facebookarchive/Surround360/surround360_render/res/example_data/color_calibration_input.png

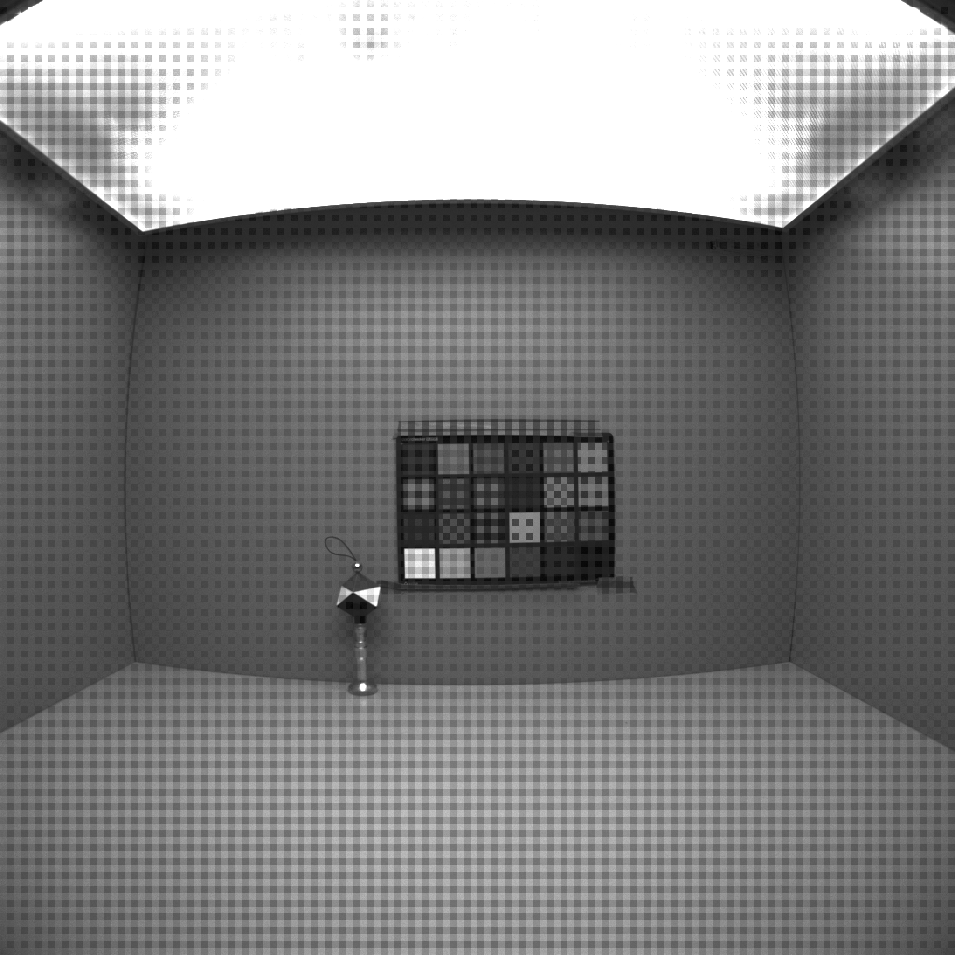
surround360_render/res/example_data/color_calibration_input.png
