facebookarchive/Surround360/surround360_render/res/example_data/test_fisheye_diffuse.png

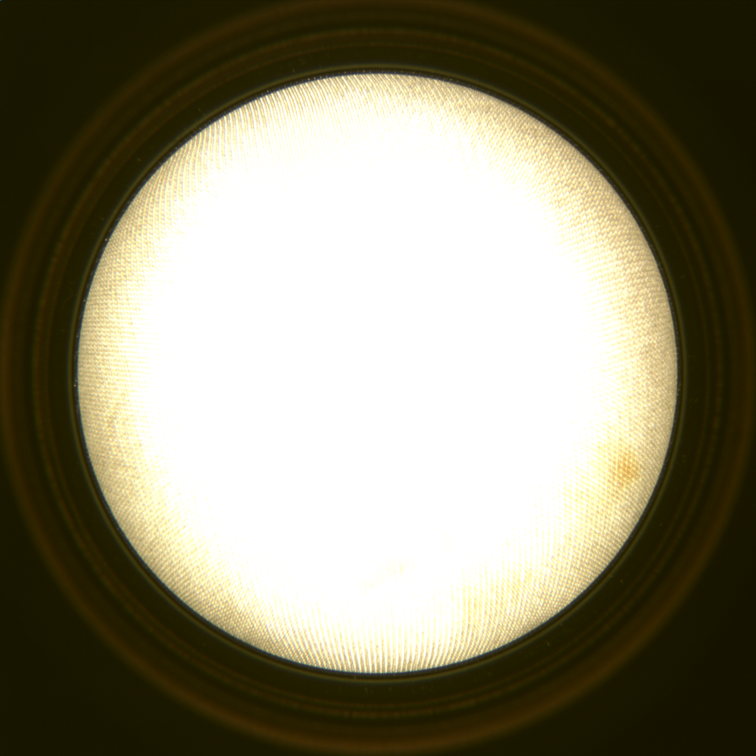
surround360_render/res/example_data/test_fisheye_diffuse.png
