facebookarchive/Surround360/surround360_design/README.md

# Surround 360 Hardware Design

The Surround 360 hardware design consists of blueprints, 3D model files for the base plates and shell, and instructions for assembly.

## Assembly Instructions

Refer to the files under /surround360/surround360_design/assembly_guide

## Join the Surround 360 community

* Website: https://facebook360.fb.com/facebook-surround-360/

See the CONTRIBUTING.md file for how to help out.

## License

The Surround 360 hardware design is licensed under the Creative Commons Attribution 4.0 International license, as it appears in LICENSE_design.md under /surround360_design.
