facebookarchive/Surround360/surround360_render/res/config/isp/README.txt

Field description for configuring the soft ISP

BlackLevel
   3 channel vector value [r, g, b]

     offset in range 0.0, 1.0 where 1.0 == 2^bits_per_channel - This
     varies by camera & sensor vendor. For the usb3 grasshoppers it is
     12.0/255.0 equally for all 3 channels.

Vignette rolloff
   5x3 matrix

       Per-channel 4th order Bezier surface control points, separable on H and V orientations.
       The control points spread uniformly on the image. Each pixel in the image is scaled
       by the corresponding value of the Bezier surface at that location.
       It is not unusual to have each of the channels roll off at different rates to 
       handle chromatic vignetting effects.

WhiteBalanceGain
   3 channel vector value [r, g, b]

       Nominally the red and blue channels are usually around 2x gain
       to the green channels. Strictly speaking this should be
       computed using a global white balance algorithm.

stuckPixelThreshold
   Single value

       The absolute difference of the center pixel from the mean of
       it's neighbors such that it is considered a candidate stuck
       pixel. A value of 0.05 is around 13 pixel counts out of 255.

stuckPixelVarianceThreshold
   Single value

       A measure of local smoothness. Such that if the local region is
       smooth and the center pixel is "candidate stuck" pixel then the
       current pixel is replaced with the local mean.  Both the mean
       and variance calculation excludes the current pixel.

denoise
   Single value

      Noise threshold value.  Zero disables noise coring. Bigger value
      remove more noise but also more signal potentially.

denoiseRadius
    Single value

      Radius for noise reduction 3 or 4 is reasonable.  1 will be fast but will leave low frequency noise behind.

ccm
   3x3 matrix  [[m00, m01, m01], ..., [m20, m21, m22]]

       An identity leaves the color unchanged. This matrix should
       calculated from a color calibration session. It usually best if
       the rows sum to unity to conserve energy.

sharpening
   3 channel vector value [r, g, b]

       1.0 means no sharpening. Below 1.o means blurring and values
       greater than 1.0 will sharpen the image. Excessive
       sharpening will cause "ringing."

saturation
    Single value

      1.0 means no saturation gain.  0.0 means no color at all
      (e.g. B & W) and values greater than one increase saturation.

contrast
     Single value

      1.0 means no contrast gain.  Values greater than one increase
      contrast.

low/high key boost
   3 channel vector value [r, g, b]
   
      Boosts low/high key colors, effectively increasing the color difference on the dark/bright
      areas of the image. It applies a 4-point Bezier curve between 0.0 and 0.5 (low key) or
      0.5 and 1.0 (high key).
      Both low/high key default to 0.0 (= flat, no change), and they can range between 
      -0.1666 and 0.1666 (-1/6 and 1/6).

gamma
   3 channel vector value [r, g, b]

      Raises the pixel value to the power of the gamma value. 0.454545
      is the  classic 2.2 gamma  used to to  move from linear  sRGB to
      gamma corrected sRGB.

bayerPattern
    Single value string

      The string is expected to contain a combination of "R" "G" and
      "B" in the payer pattern order left to right, top to bottom. So
      a Bayer pattern of:

         R G
         G B

      Would be "RGGB"
