facebookarchive/Surround360/surround360_render/res/example_data/intrinsic_checkerboard.png

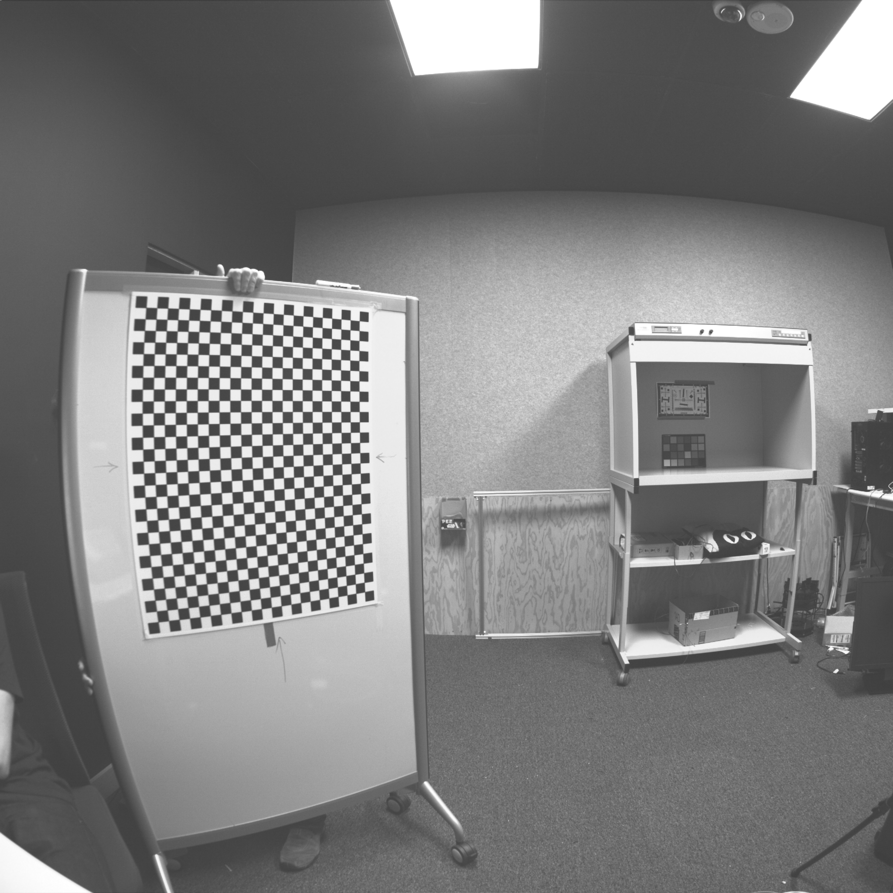
surround360_render/res/example_data/intrinsic_checkerboard.png
