facebookarchive/Surround360/surround360_render/res/pole_masks/cam15.png

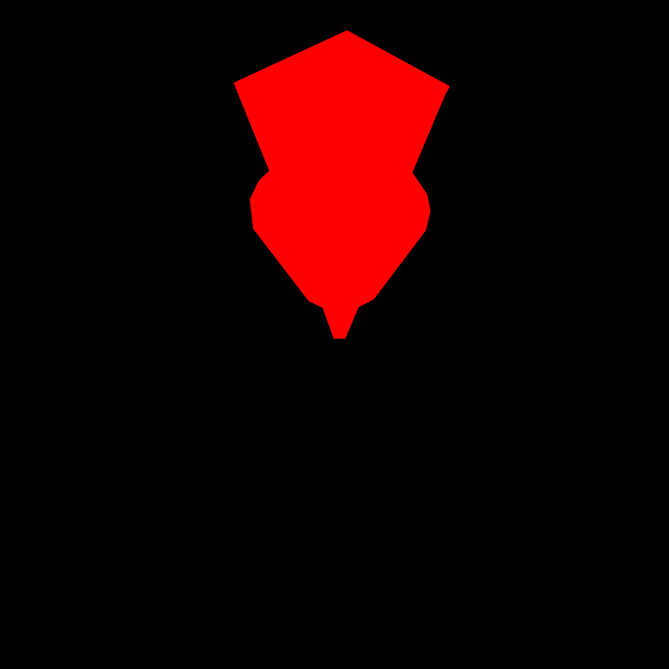
surround360_render/res/pole_masks/cam15.png
