facebookarchive/Surround360/surround360_design/3d_models/STEP_files/160523_3.STEP

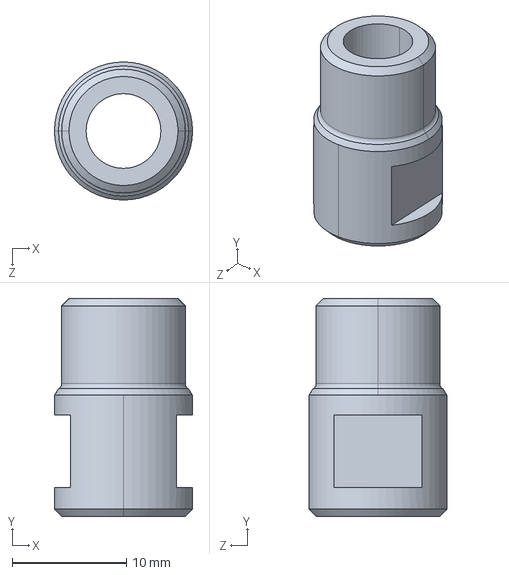
[picture p6: CAD file, 2016-07-26]
surround360_design/3d_models/STEP_files/160523_3.STEP
12.1 x 19.1 x 12.1 mm
