facebookarchive/Surround360/surround360_design/3d_models/STEP_files/FB360_V1_21.STEP

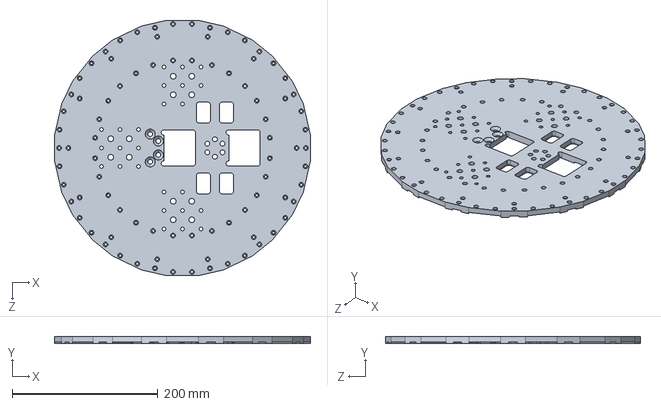
[picture p8: CAD file, 2016-07-26, an earlier design]
surround360_design/3d_models/STEP_files/FB360_V1_21.STEP
351.1 x 9.52 x 350.0 mm
