facebookarchive/Surround360/surround360_design/3d_models/STEP_files/FB360_V1_24.STEP

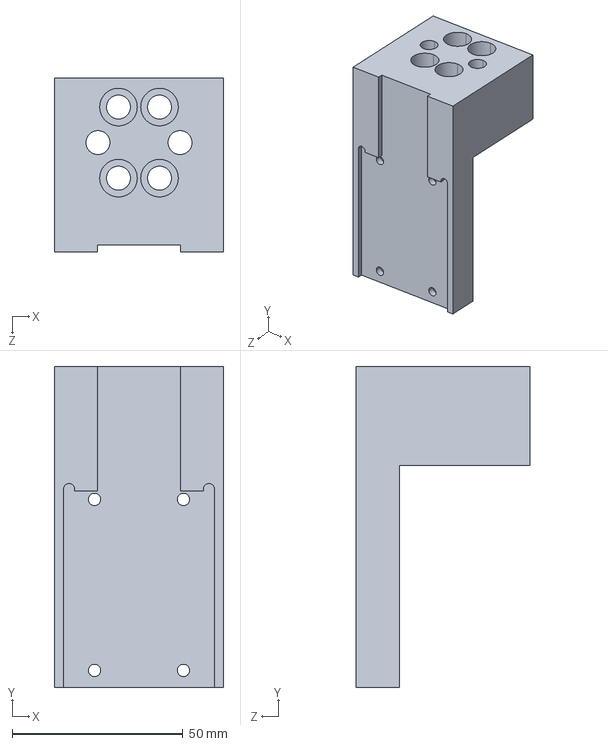
[picture p9: CAD file, 2016-07-26, an earlier design]
surround360_design/3d_models/STEP_files/FB360_V1_24.STEP
49.5 x 93.9 x 50.8 mm
