facebookarchive/Surround360/surround360_design/3d_models/STEP_files/FB360_V1_32.STEP

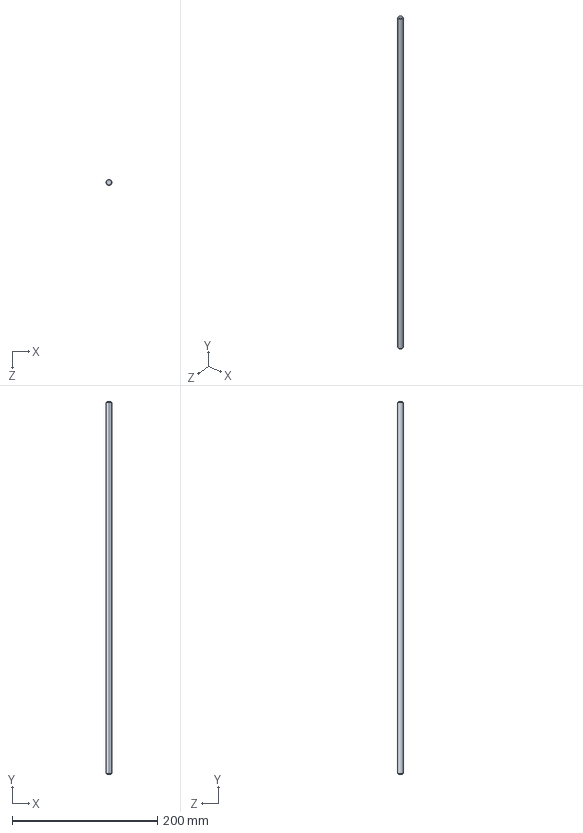
[picture p10: CAD file, 2016-07-26, an earlier design]
surround360_design/3d_models/STEP_files/FB360_V1_32.STEP
7.94 x 514.4 x 7.94 mm
