facebookarchive/Surround360/surround360_design/3d_models/STEP_files/FB360_V1_27.STEP

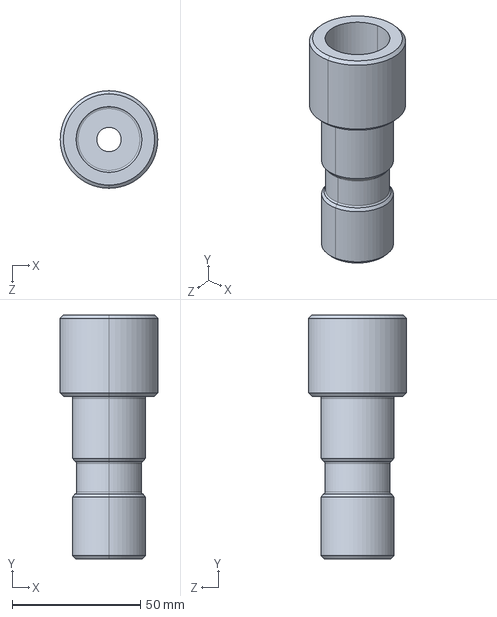
[picture p11: CAD file, 2016-07-26, an earlier design]
surround360_design/3d_models/STEP_files/FB360_V1_27.STEP
38.1 x 95.2 x 38.1 mm
