facebookarchive/Surround360/surround360_design/3d_models/STEP_files/FB360_V1_25.STEP

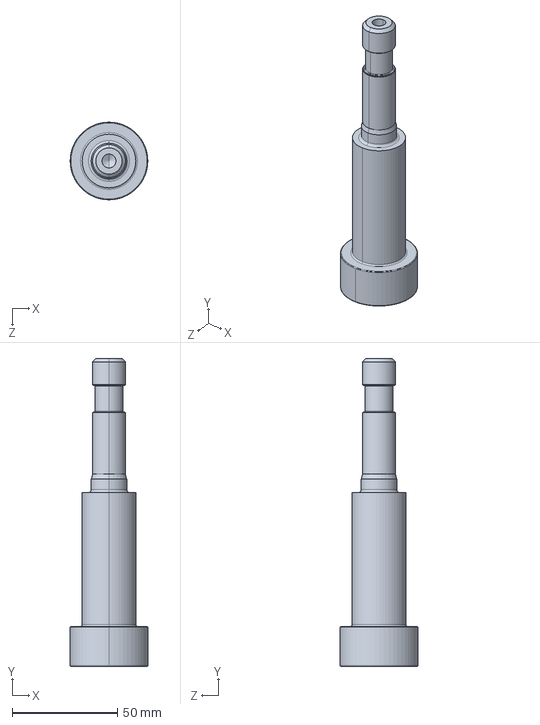
[picture p13: CAD file, 2016-07-26, an earlier design]
surround360_design/3d_models/STEP_files/FB360_V1_25.STEP
36.8 x 146.0 x 36.8 mm
