facebookarchive/Surround360/surround360_design/3d_models/STEP_files/FB360_V1_28.STEP

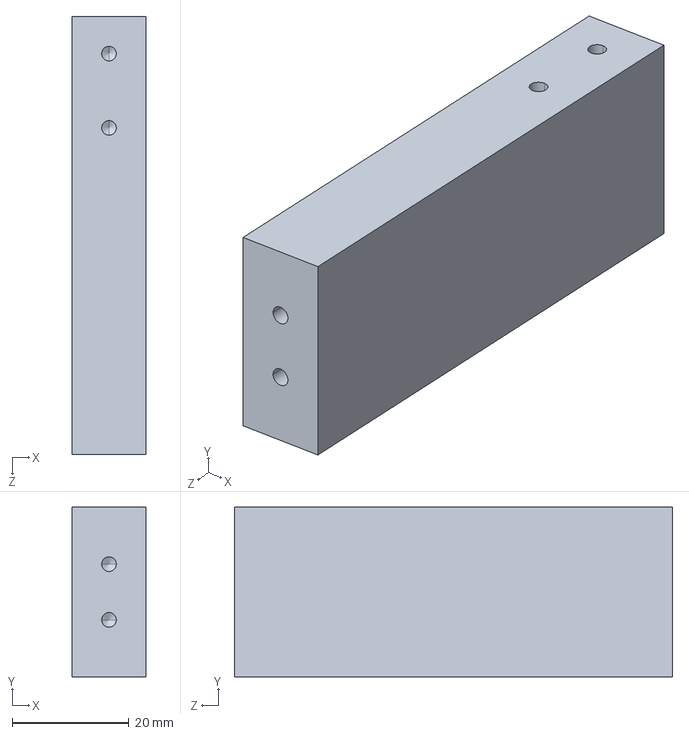
[picture p14: CAD file, 2016-07-26, an earlier design]
surround360_design/3d_models/STEP_files/FB360_V1_28.STEP
12.6 x 29.0 x 74.9 mm
