facebookarchive/Surround360/surround360_design/3d_models/STEP_files/FB360_V1_26.STEP

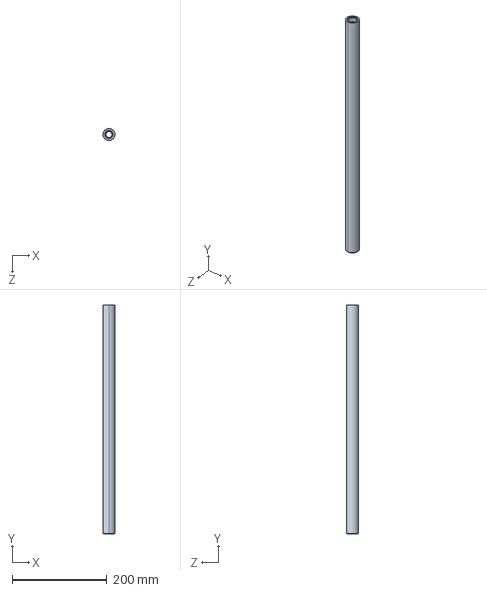
[picture p15: CAD file, 2016-07-26, an earlier design]
surround360_design/3d_models/STEP_files/FB360_V1_26.STEP
25.4 x 482.6 x 25.4 mm
