facebookarchive/Surround360/(list of files, cad)

Other CAD files:
surround360_design/3d_models/STEP_files/FB360_V1_31.STEP
