facebookarchive/Surround360/surround360_render/res/example_data/vignetting_calibration_fit.png

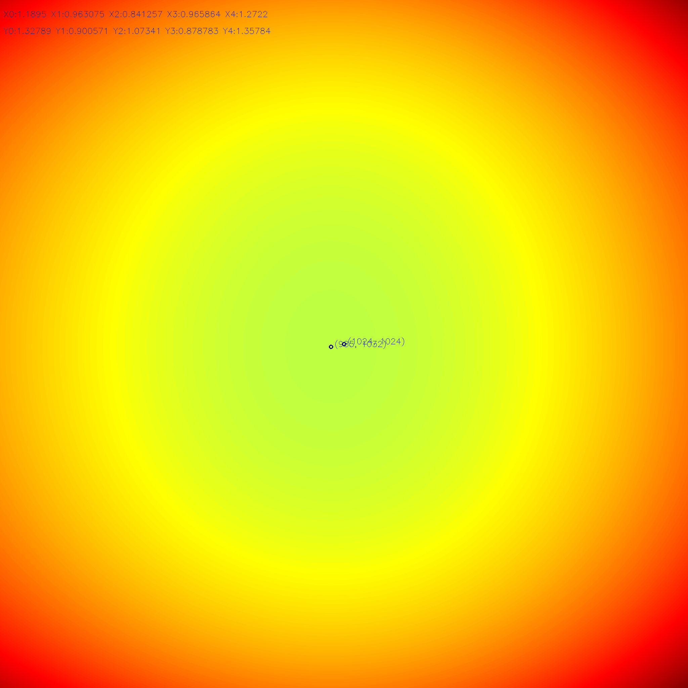
surround360_render/res/example_data/vignetting_calibration_fit.png
