facebookarchive/Surround360/surround360_design/drawings/FB360_V1_ALL.pdf

12

A

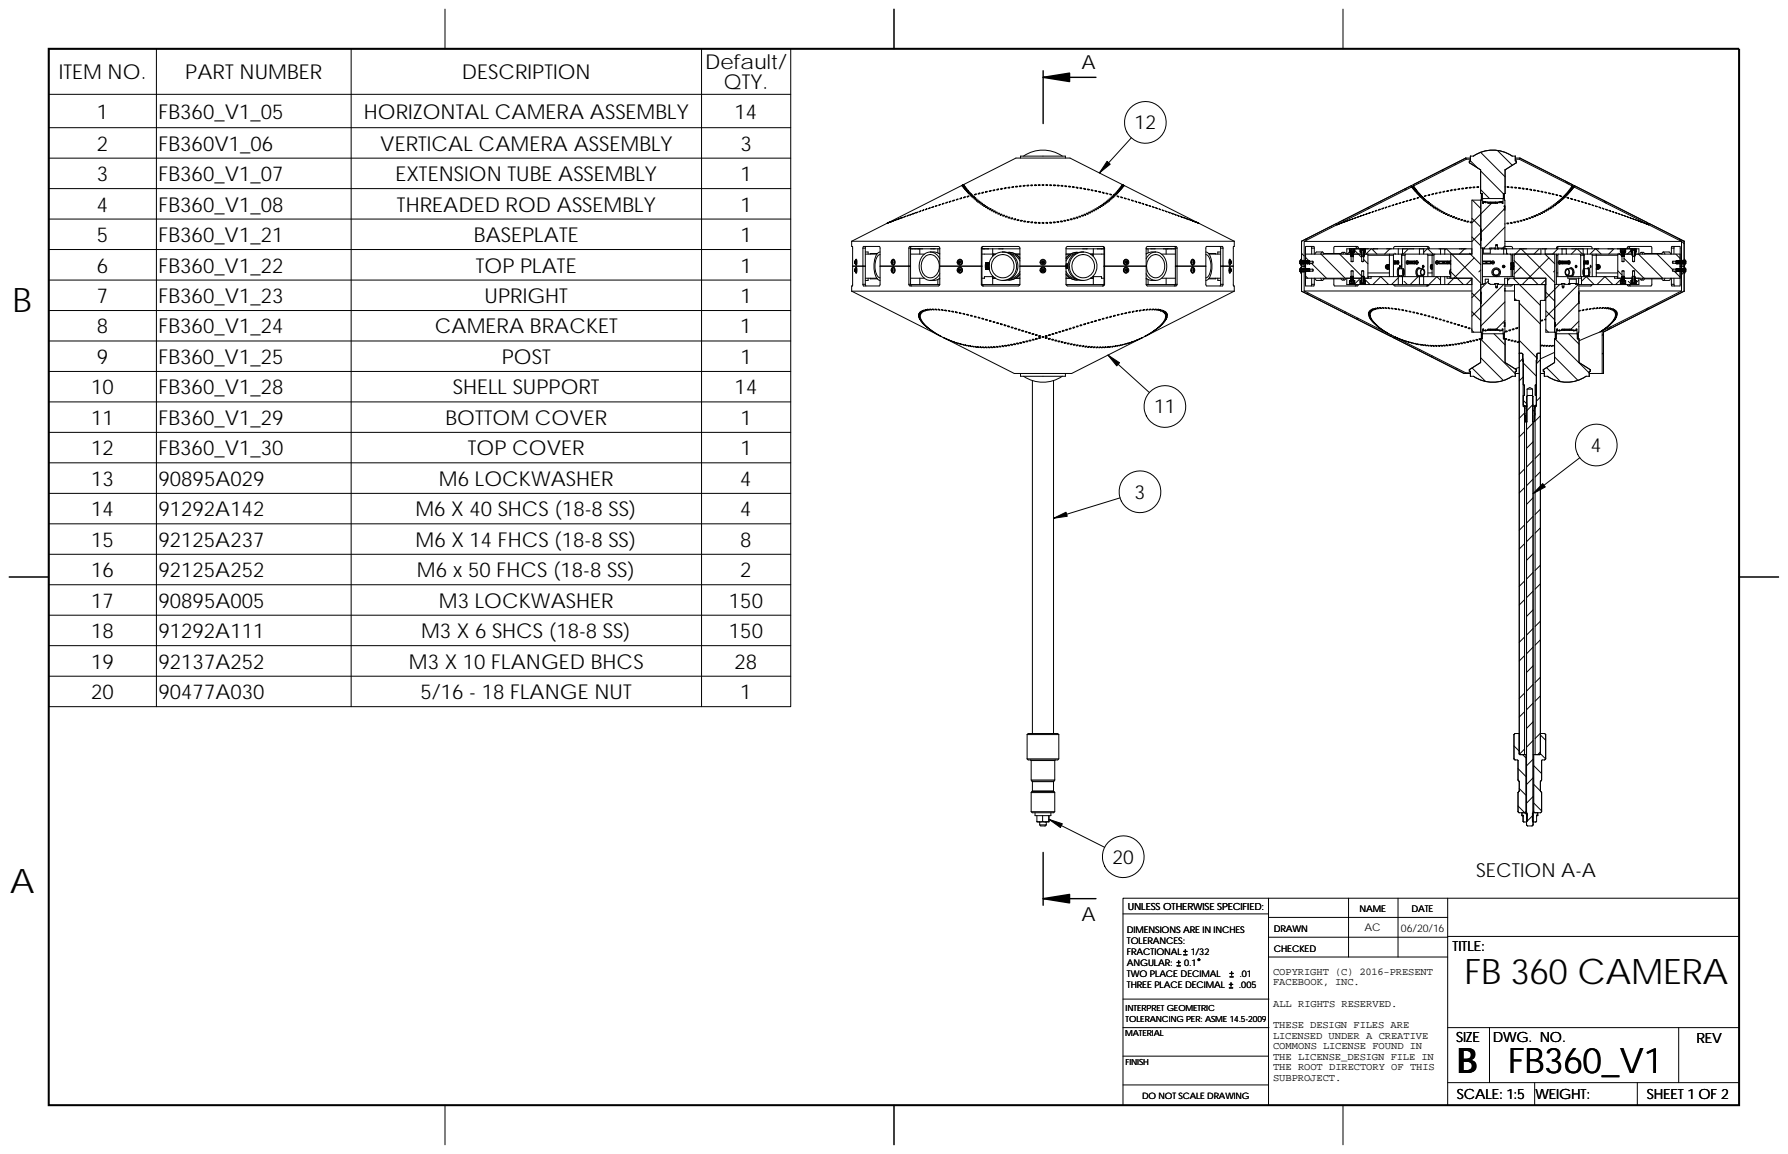
[picture p17: page 1]
SECTION A-A; ITEM NO.; PART NUMBER; DESCRIPTION; Default/ QTY.; HORIZONTAL CAMERA ASSEMBLY; VERTICAL CAMERA ASSEMBLY; EXTENSION TUBE ASSEMBLY; THREADED ROD ASSEMBLY; BASEPLATE; TOP PLATE; UPRIGHT; CAMERA BRACKET; POST; SHELL SUPPORT; BOTTOM COVER; TOP COVER; M6 LOCKWASHER; M6 X 40 SHCS (18-8 SS); M6 X 14 FHCS (18-8 SS); M6 x 50 FHCS (18-8 SS); M3 LOCKWASHER; M3 X 6 SHCS (18-8 SS); M3 X 10 FLANGED BHCS; 5/16 - 18 FLANGE NUT; FB 360 CAMERA; SHEET 1 OF 2; SCALE: 1:5; WEIGHT:; DWG. NO.; REV; SIZE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

UNLESS OTHERWISE SPECIFIED:

DIMENSIONS ARE IN INCHES
TOLERANCES:
FRACTIONAL 1/32
FRACTIONAL
ANGULAR:
ANGULAR: 0.1
TWO PLACE DECIMAL
THREE PLACE DECIMAL

DRAWN DRAWN DRAWN | AC | 06/20/16

CHECKED

COPYRIGHT (C) 2016-PRESENT
FACEBOOK, INC.
ALL RIGHTS RESERVED.
THESE DESIGN FILES ARE
LICENSED UNDER A CREATIVE
COMMONS LICENSE FOUND IN
THE LICENSE_DESIGN FILE IN
THE ROOT DIRECTORY OF THIS
SUBPROJECT.

INTERPRET GEOMETRIC
TOLERANCING PER: ASME 14.5-2009
MATERIAL

DO NOT SCALE DRAWING

# NOTE: ITEM NUMBERS 3, 4, 11, 12 AND 20 REMOVED FOR CLARITY

# NOTE: ITEM NUMBERS 3, 4, 6, 11, 12 AND 20 REMOVED FOR CLARITY

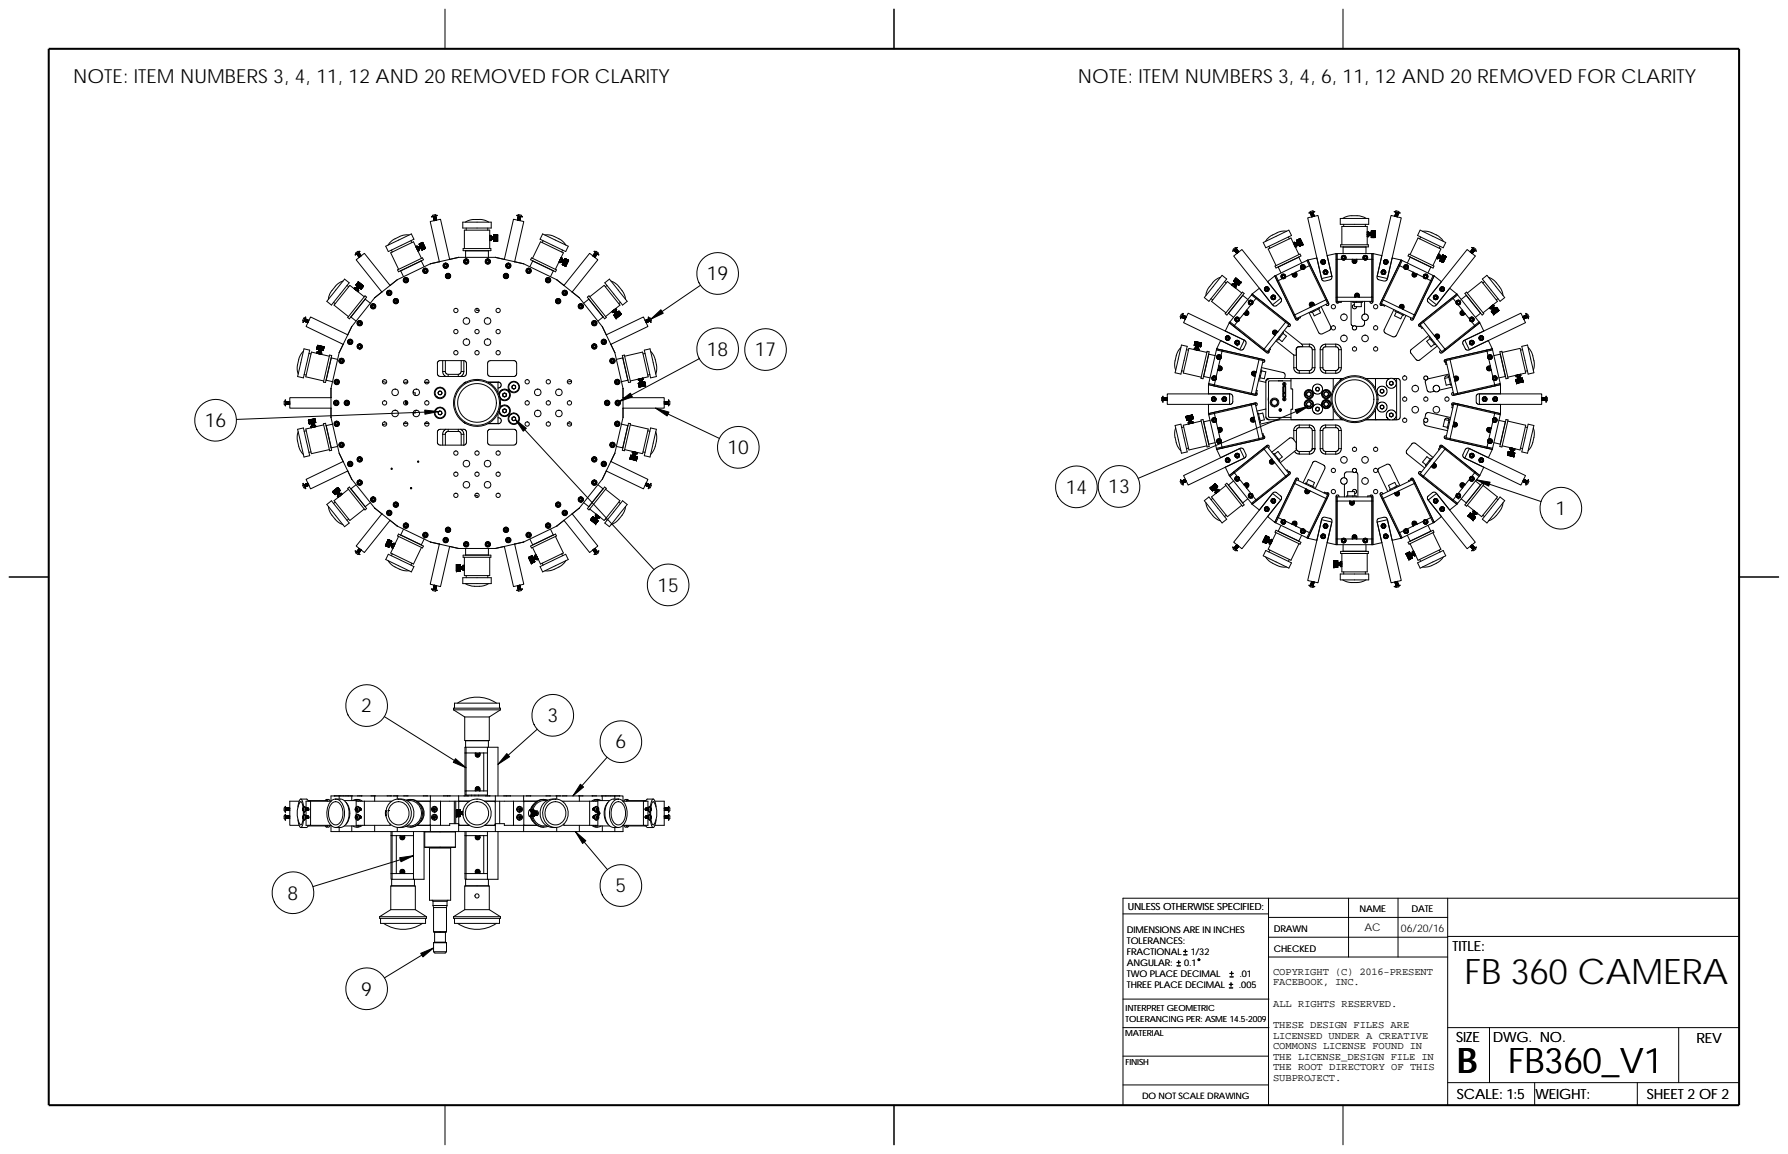
[picture p18: page 2]
SCALE: 1:5; WEIGHT:; DWG. NO.; REV; SIZE; INTERPRET GEOMETRIC; MATERIAL

UNLESS OTHERWISE SPECIFIED: | | NAME | DATE
DIMENSIONS ARE IN INCHES TOLERANCES: TOLERANCES: FRACTIONAL 1/32 1/32 .01 ANGULAR: ANGULAR: 0.1 TWO PLACE DECIMAL TWO PLACE DECIMAL .01 THREE PLACE DECIMAL .005 | DRAWN | AC | 06/20/16
CHECKED | | | TITLE: TITLE: FB 360 CAMERA

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

INTERPRET GEOMETRIC
TOLERANCING PER: ASME 14.5-2009
MATERIAL

ITEM NO. | PART NUMBER | DESCRIPTION | QTY.
1 | PT_GRY_CAMERA | CAMERA MODULE | 1

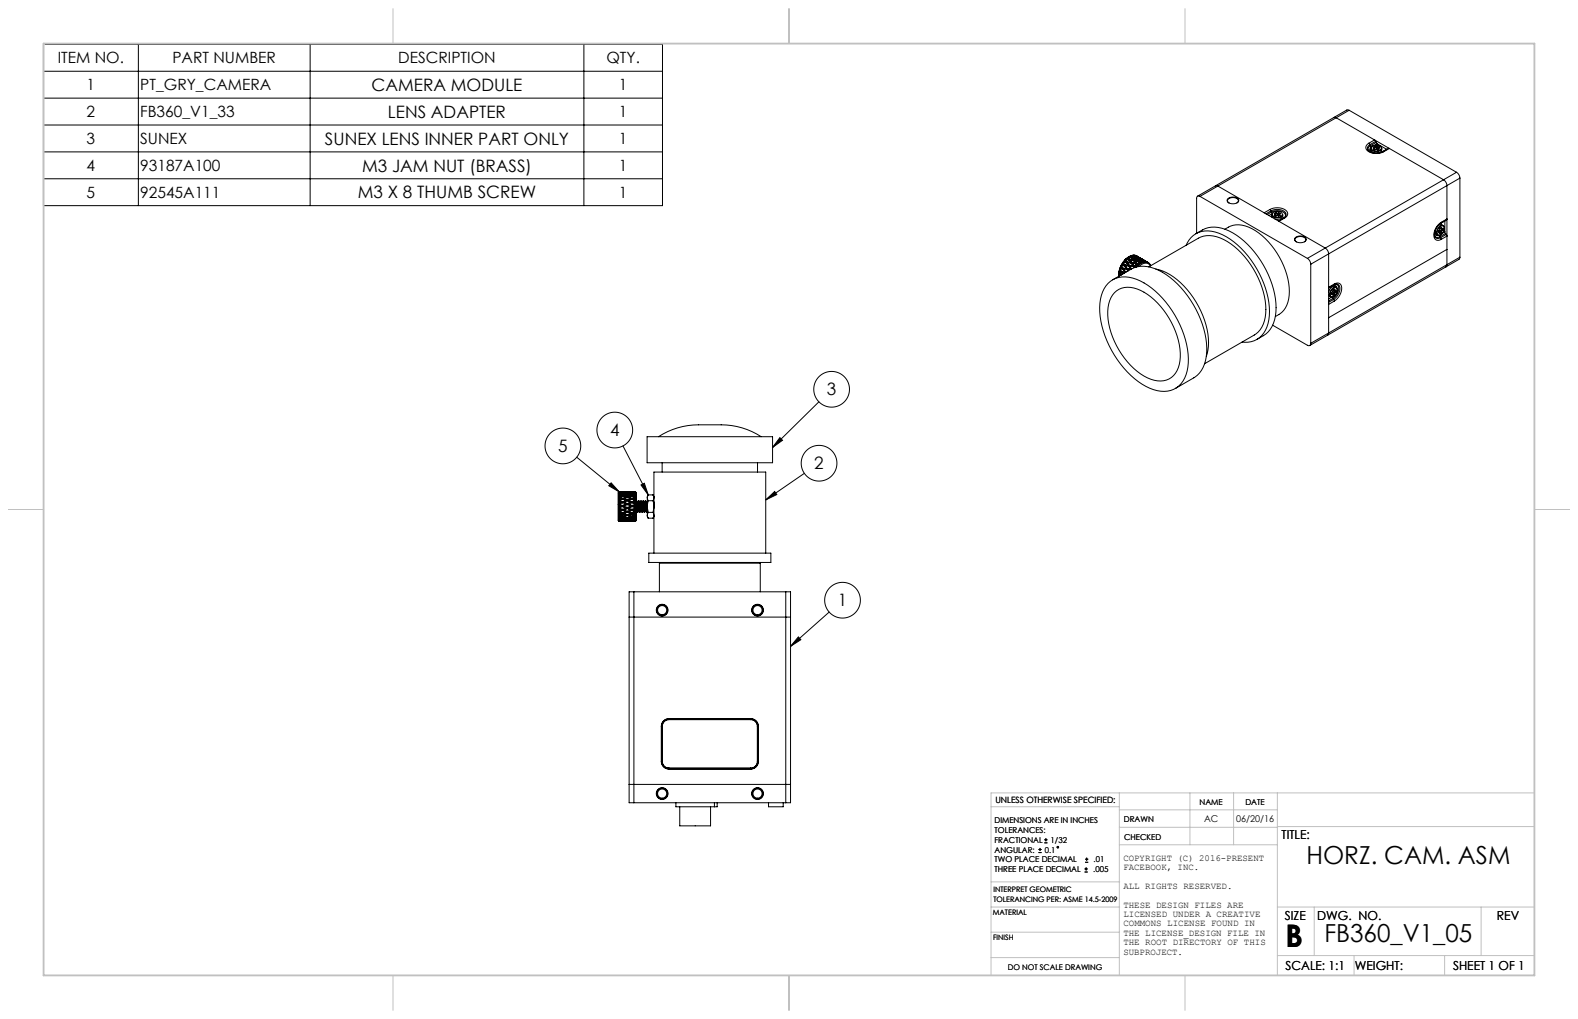
[picture p19: page 3]
SCALE: 1:1; WEIGHT:; DWG. NO.; REV; SIZE; DO NOT SCALE DRAWING; SHEET 1 OF 1

2 | FB360_V1_33 | LENS ADAPTER | 1
3 | SUNEX | SUNEX LENS INNER PART ONLY | 1
4 | 93187A100 | M3 JAM NUT (BRASS) | 1
5 | 92545A111 | M3 X 8 THUMB SCREW | 1

UNLESS OTHERWISE SPECIFIED: | | NAME | DATE
DIMENSIONS ARE IN INCHES DIMENSIONS ARE IN INCHES TOLERANCES: TOLERANCES: FRACTIONAL 1/32 FRACTIONAL 1/32 ANGULAR: 0.1 ANGULAR: 0.1 TWO PLACE DECIMAL TWO PLACE DECIMAL .01 .01 THREE PLACE DECIMAL .005 THREE PLACE DECIMAL .005 | DRAWN | AC | 06/20/16

CHECKED | | | TITLE: TITLE: HORZ. CAM. ASM

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

INTERPRET GEOMETRIC
TOLERANCING PER: ASME 14.5-2009
MATERIAL

ITEM NO. | PART NUMBER | DESCRIPTION | QTY.
1 | PT_GRY_CAMERA | CAMERA MODULE | 1

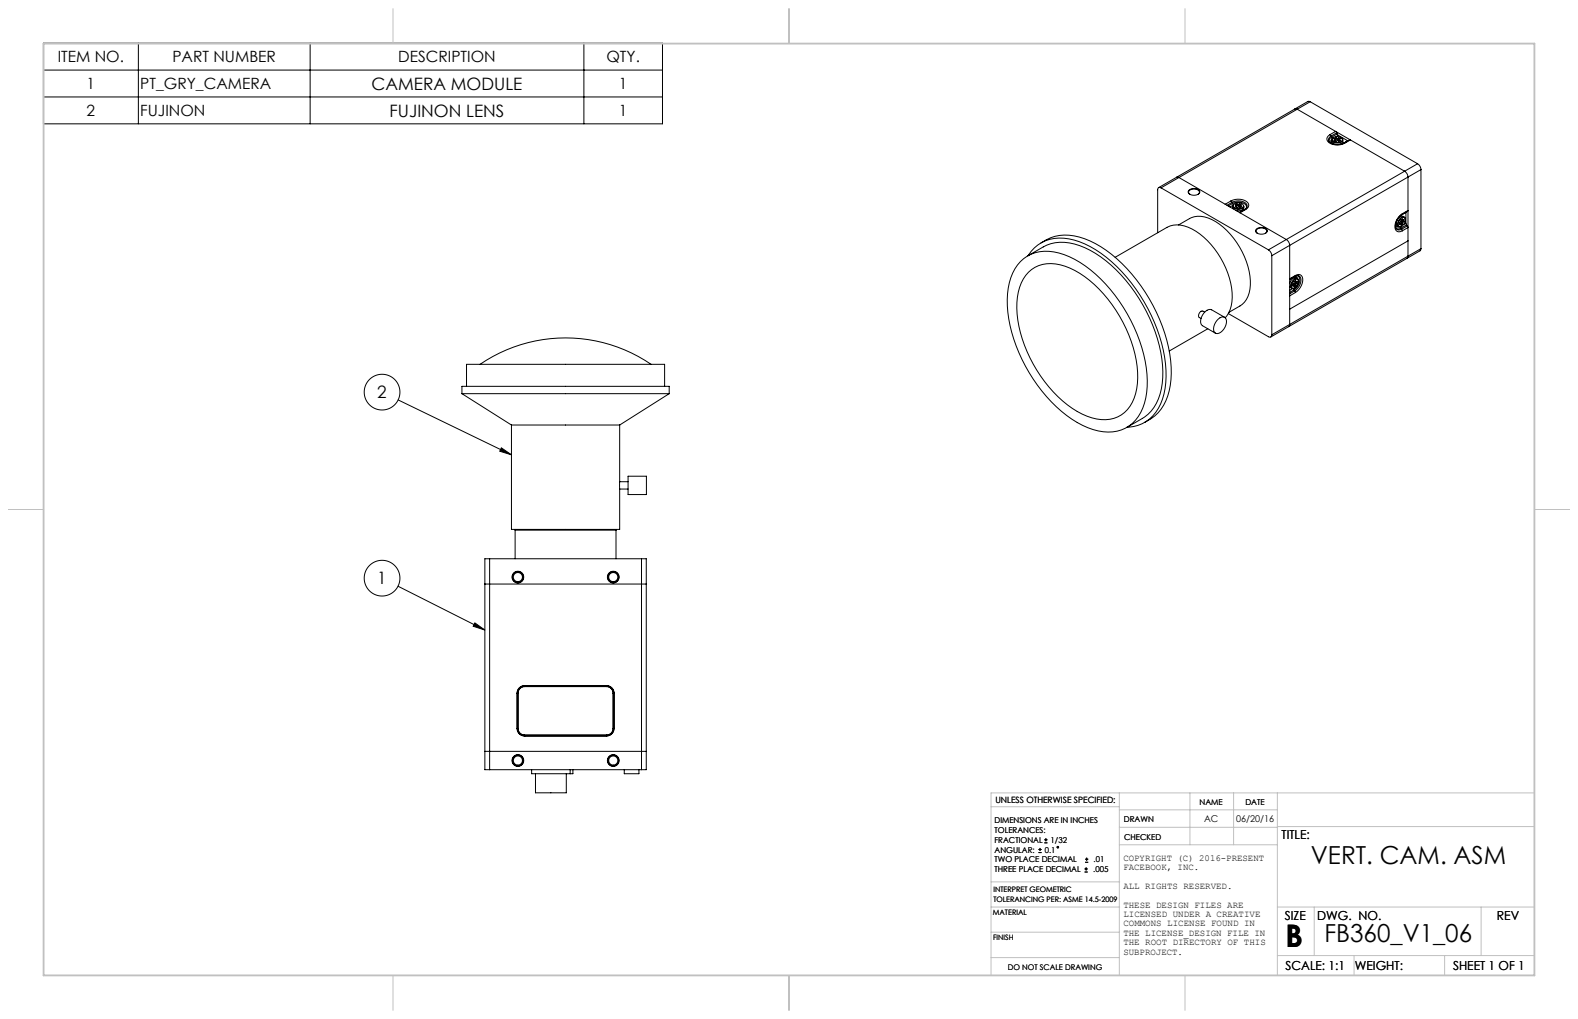
[picture p20: page 4]
SCALE: 1:1; WEIGHT:; DWG. NO.; REV; SIZE

2 | FUJINON | FUJINON LENS | 1

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

CHECKED | | | TITLE: TITLE: VERT. CAM. ASM

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

INTERPRET GEOMETRIC
TOLERANCING PER: ASME 14.5-2009
MATERIAL

A

ITEM NO. | PART NUMBER | DESCRIPTION | QTY.

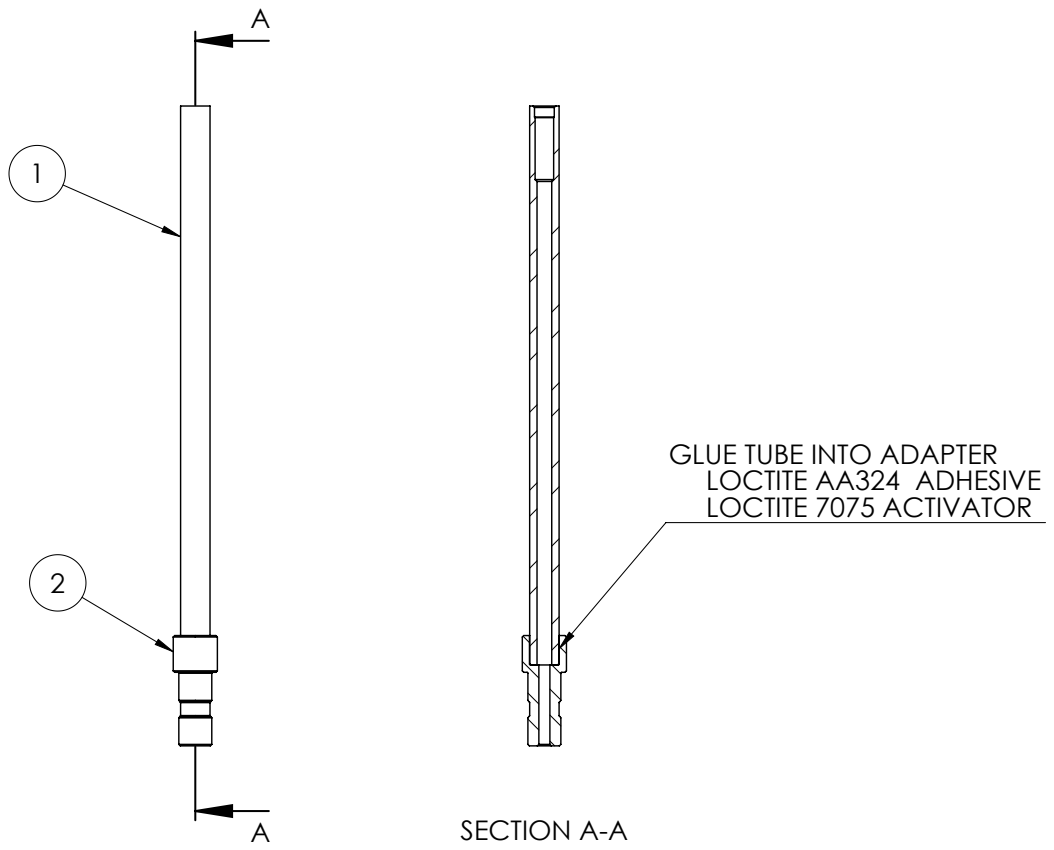
[picture p21: page 5]
SECTION A-A; SCALE: 1:5; WEIGHT:; DWG. NO.; REV; SIZE

1 | FB360_V1_26 | SUPPORT TUBE | 1
2 | FB360_V1_27 | ADAPTER | 1

GLUE TUBE INTO ADAPTER
LOCTITE AA324 ADHESIVE
LOCTITE 7075 ACTIVATOR

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

CHECKED | | | TITLE: TITLE: POST ASM.

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

INTERPRET GEOMETRIC
TOLERANCING PER: ASME 14.5-2009
MATERIAL

ITEM NO. | PART NUMBER | DESCRIPTION | QTY.
1 | FB360_V1_32 | 5/16-18 B7 THREADED ROD | 1

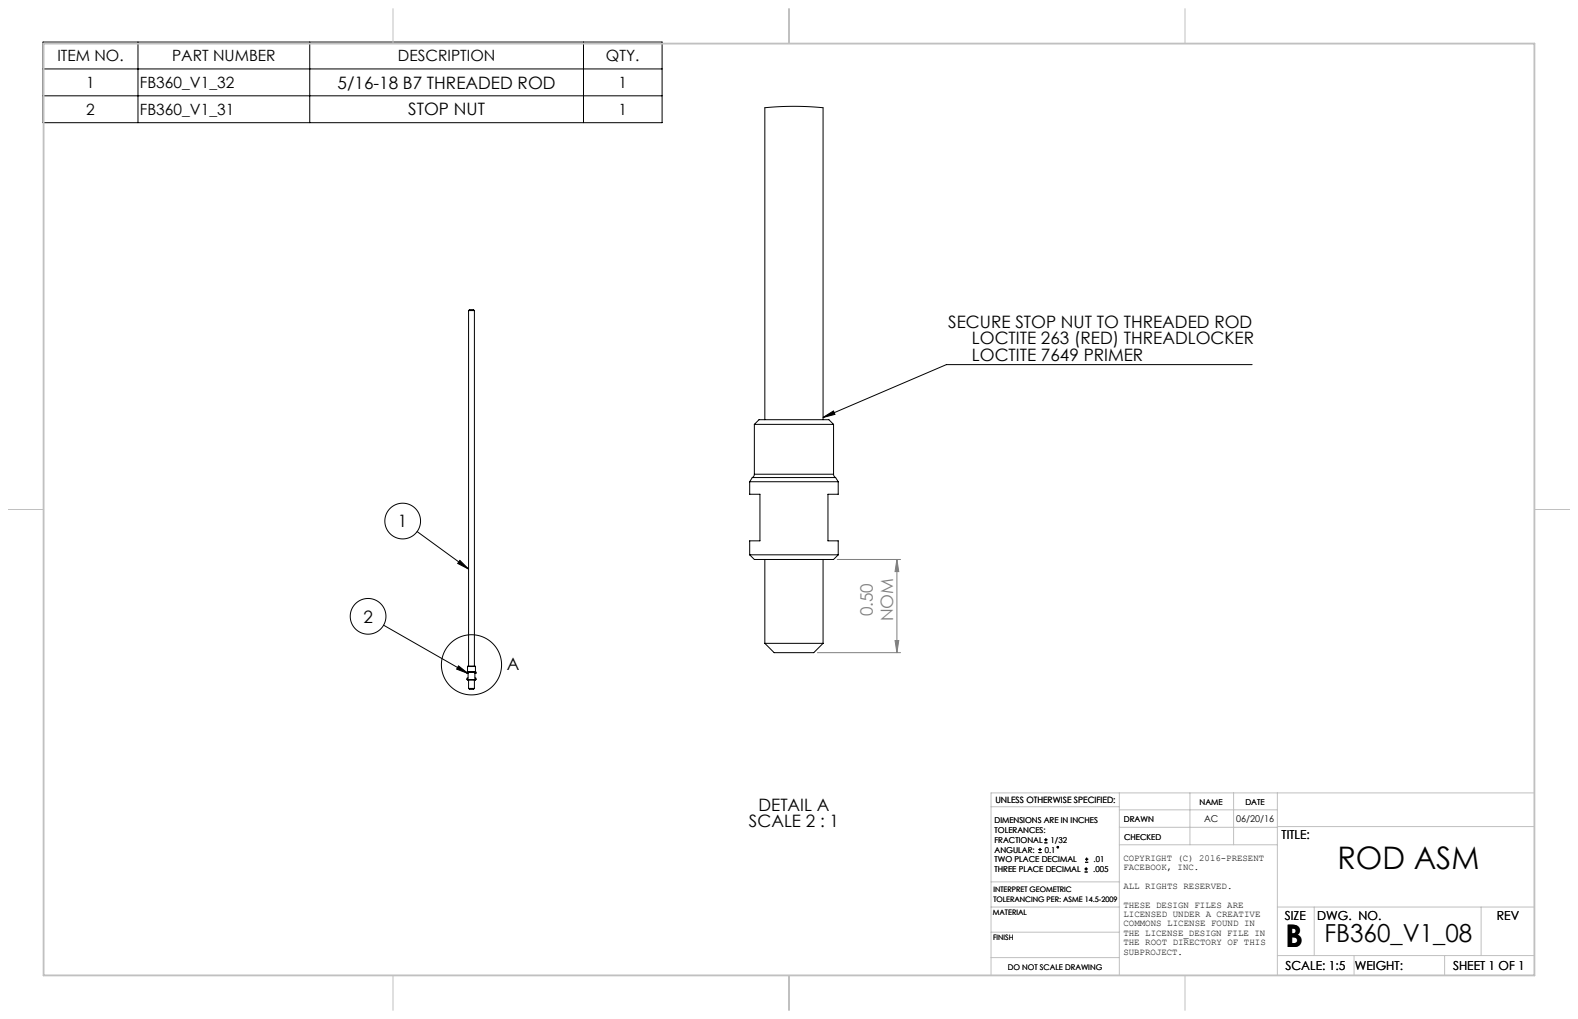
[picture p22: page 6]
NOM; DETAIL A SCALE 2 : 1; SCALE: 1:5; WEIGHT:; DWG. NO.; REV; SIZE

2 | FB360_V1_31 | STOP NUT | 1

SECURE STOP NUT TO THREADED ROD
LOCTITE 263 (RED) THREADLOCKER
LOCTITE 7649 PRIMER

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

CHECKED | | | TITLE: TITLE: ROD ASM

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

INTERPRET GEOMETRIC
TOLERANCING PER: ASME 14.5-2009
MATERIAL

1.741
1.739

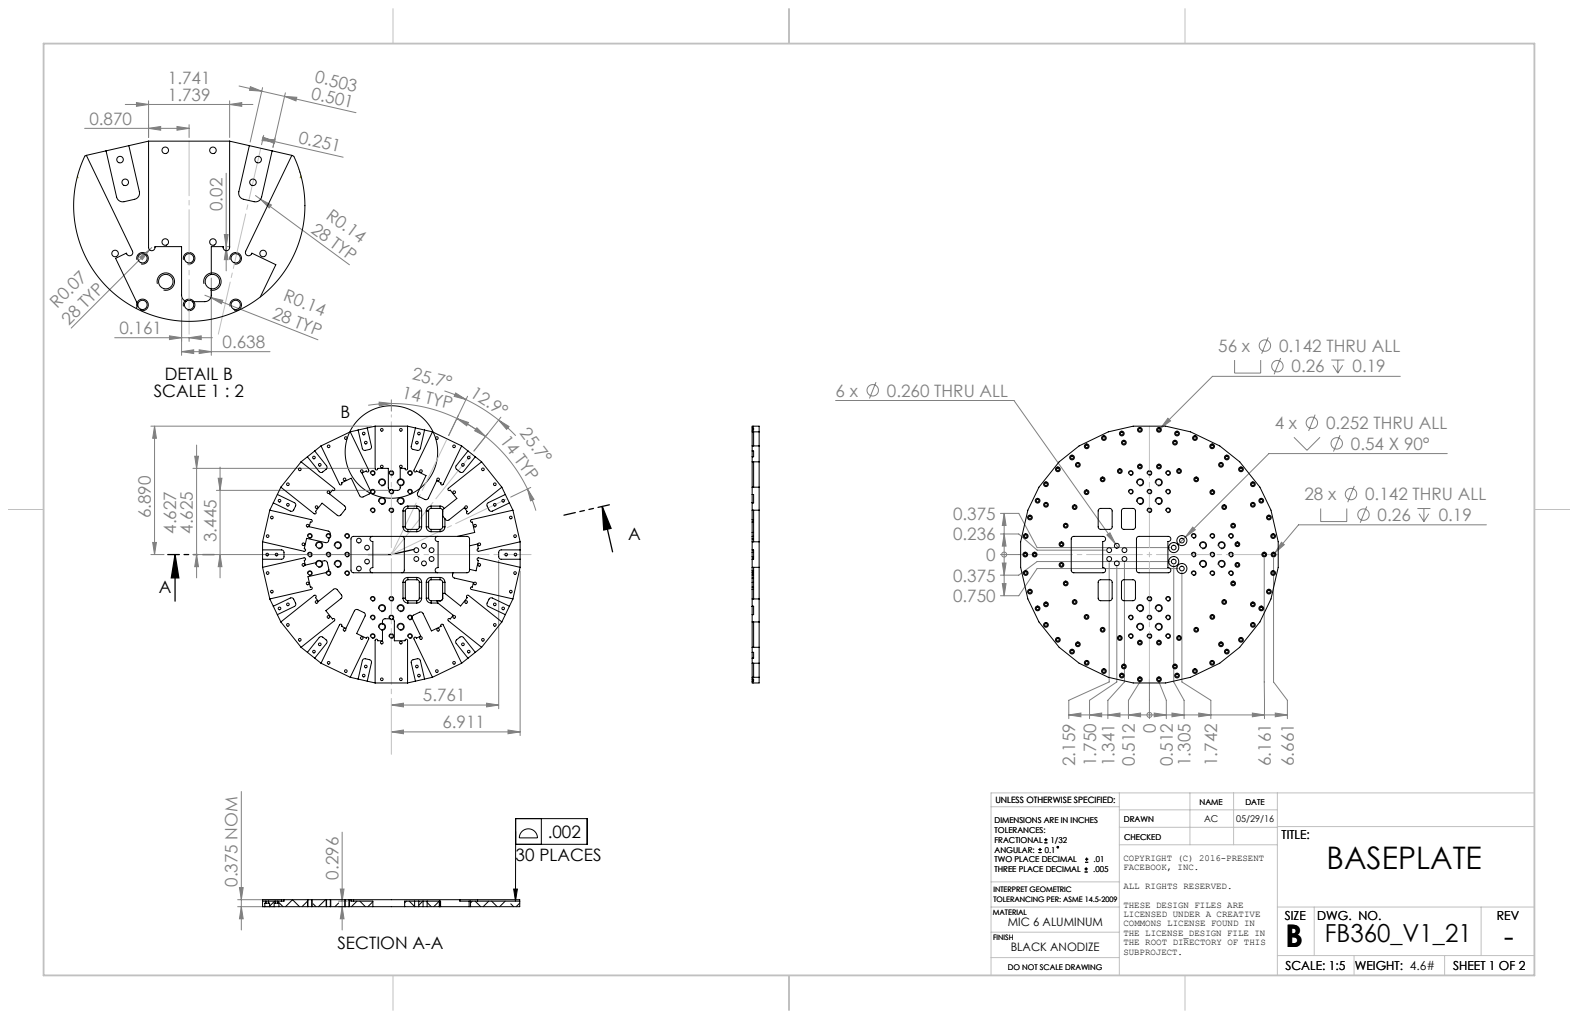
[picture p23: page 7]
25.7° 14 TYP; R0.07 28 TYP; R0.14 28 TYP; DETAIL B SCALE 1 : 2 0.375 NOM; SECTION A-A; 30 PLACES; 0.142 THRU ALL; 0.260 THRU ALL; 0.252 THRU ALL; SCALE: 1:5; WEIGHT: 4.6#; DWG. NO.; REV; SIZE; WEIGHT:

UNLESS OTHERWISE SPECIFIED: | | NAME | DATE
DIMENSIONS ARE IN INCHES DIMENSIONS ARE IN INCHES TOLERANCES: TOLERANCES: FRACTIONAL 1/32 FRACTIONAL 1/32 ANGULAR: 0.1 ANGULAR: 0.1 TWO PLACE DECIMAL TWO PLACE DECIMAL .01 .01 THREE PLACE DECIMAL .005 THREE PLACE DECIMAL .005 | DRAWN | AC | 05/29/16

CHECKED | | | TITLE: TITLE: BASEPLATE

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

INTERPRET GEOMETRIC
TOLERANCING PER: ASME 14.5-2009
MATERIAL
- DO NOT SCALE DRAWING
MIC 6 ALUMINUM
BLACK ANODIZE FINISH

# RADIUS 0.13

# 18 x 0.201 THRU ALL

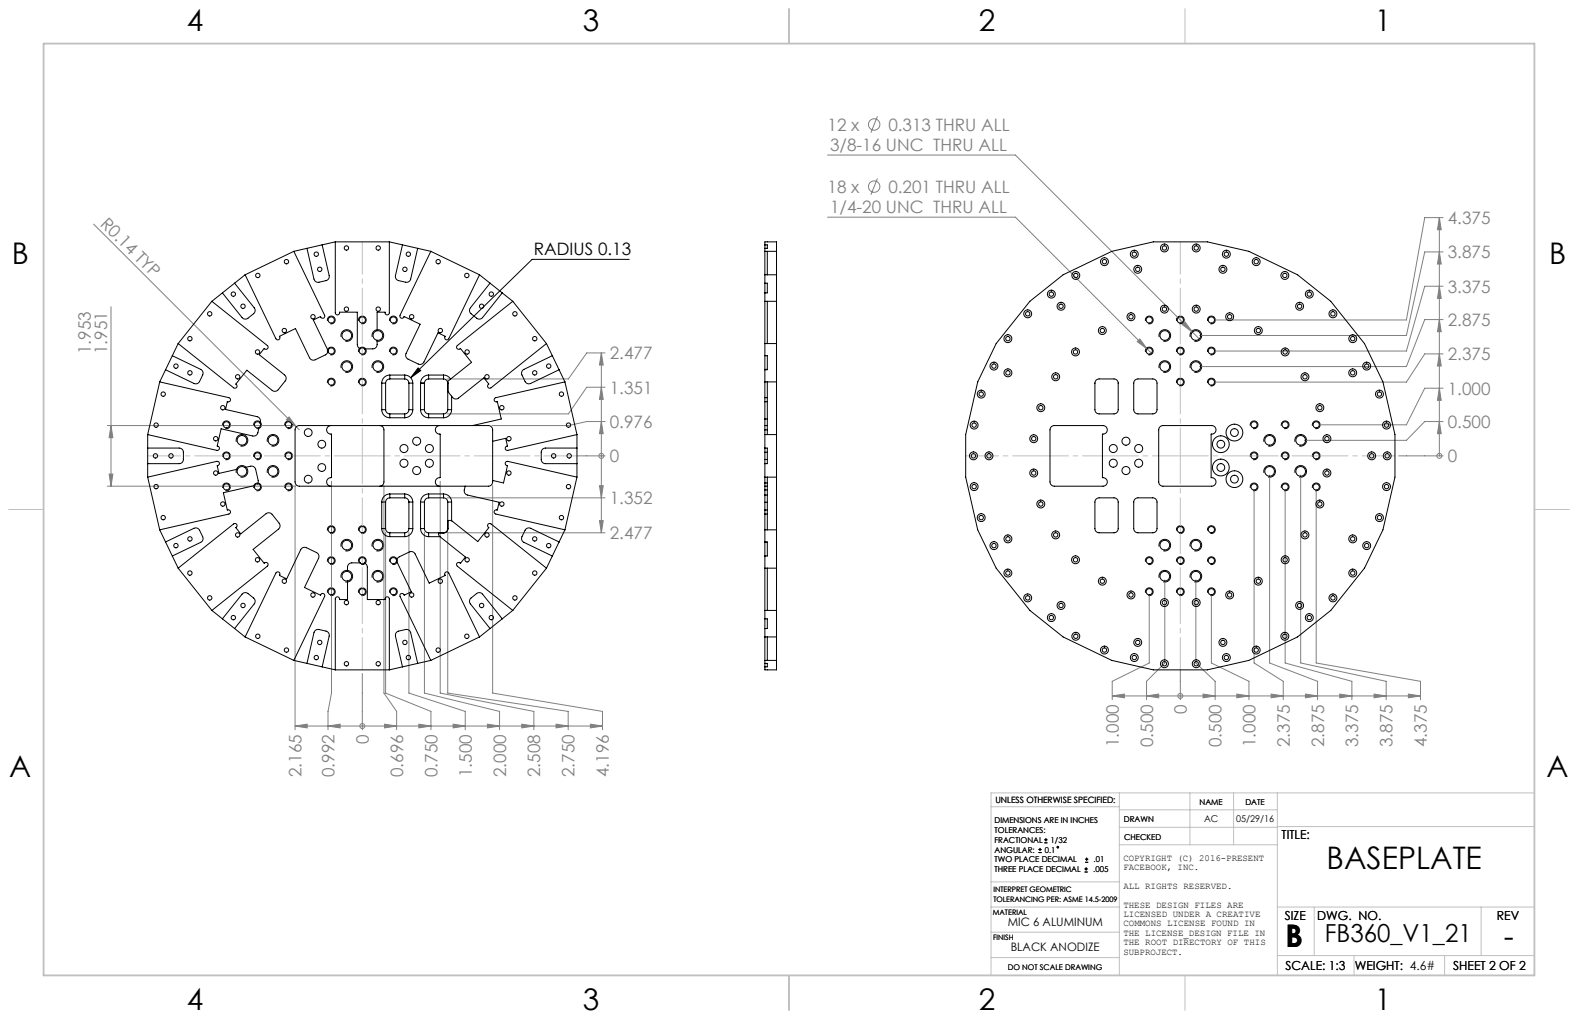
[picture p24: page 8]
R0.14 TYP; 0.313 THRU ALL; SCALE: 1:3; WEIGHT: 4.6#; DWG. NO.; REV; SIZE; WEIGHT:

3/8-16 UNC THRU ALL

1/4-20 UNC THRU ALL

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

CHECKED | | | TITLE: TITLE: BASEPLATE

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

6.890

# 0.250 NOM

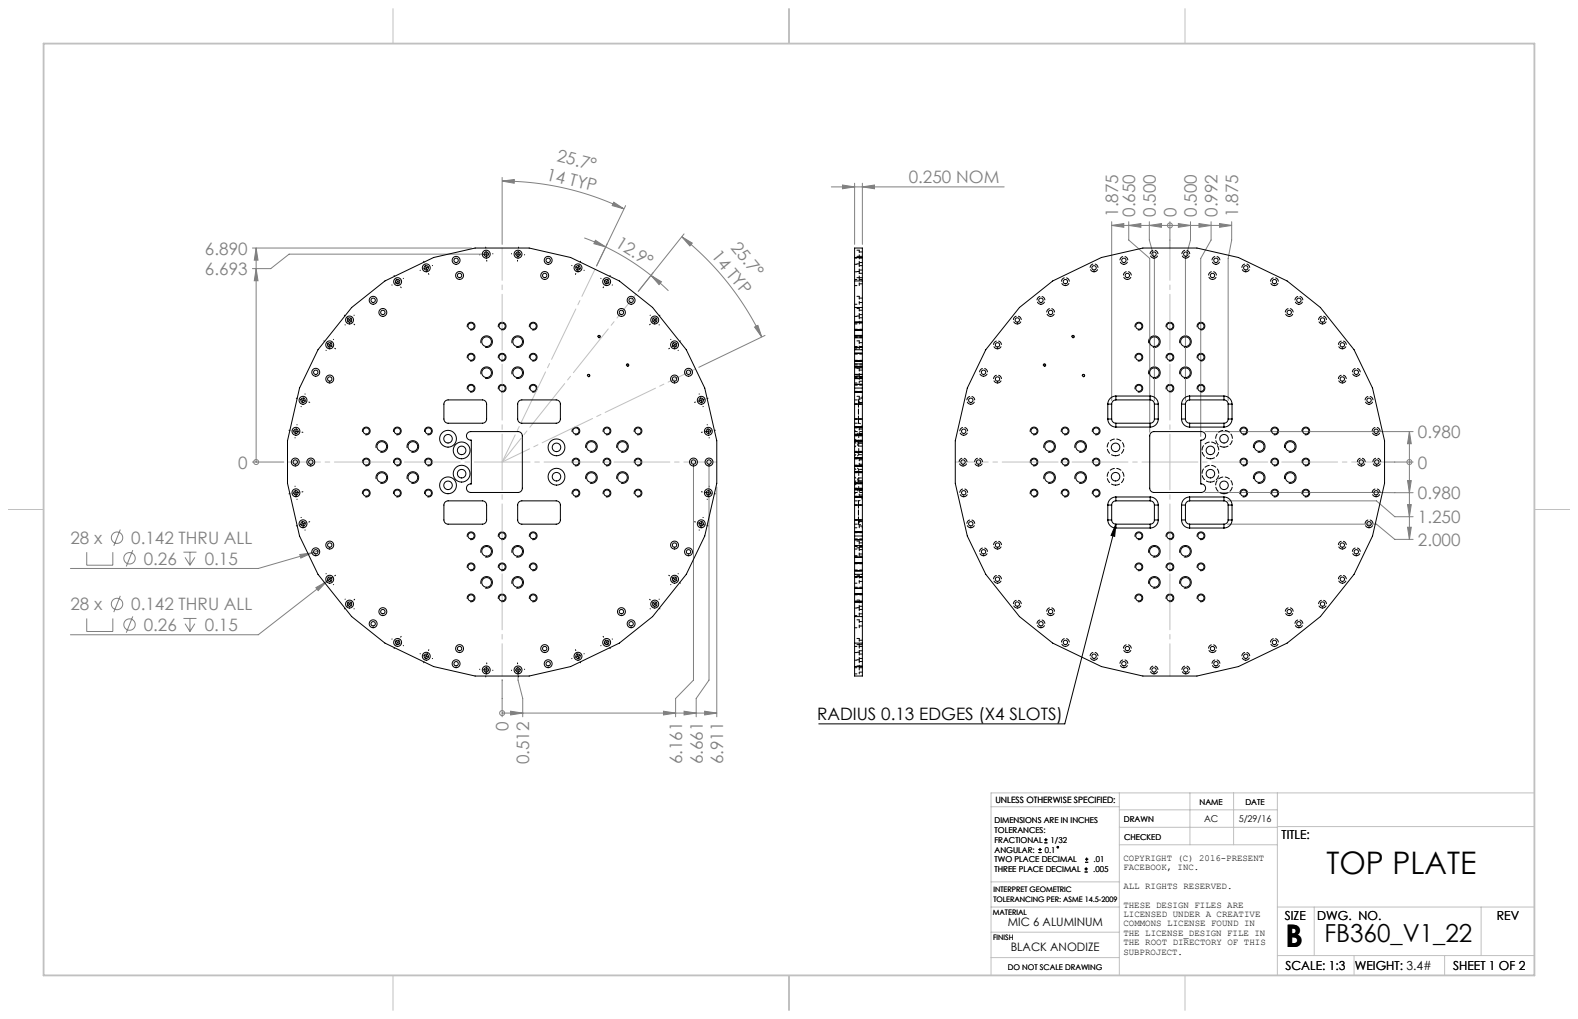
[picture p25: page 9]
0.142 THRU ALL; 25.7° 14 TYP; SCALE: 1:3; WEIGHT: 3.4#; DWG. NO.; REV; SIZE; WEIGHT:

RADIUS 0.13 EDGES (X4 SLOTS)

UNLESS OTHERWISE SPECIFIED: | | NAME | DATE
DIMENSIONS ARE IN INCHES DIMENSIONS ARE IN INCHES TOLERANCES: TOLERANCES: FRACTIONAL 1/32 FRACTIONAL 1/32 ANGULAR: 0.1 ANGULAR: 0.1 TWO PLACE DECIMAL TWO PLACE DECIMAL .01 .01 THREE PLACE DECIMAL .005 THREE PLACE DECIMAL .005 | DRAWN | AC | 5/29/16

CHECKED | | | TITLE: TITLE: TOP PLATE

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

INTERPRET GEOMETRIC
TOLERANCING PER: ASME 14.5-2009
MATERIAL
MIC 6 ALUMINUM
BLACK ANODIZE FINISH

# 3 x 0.063 THRU ALL M2x0.4 - 6H THRU ALL

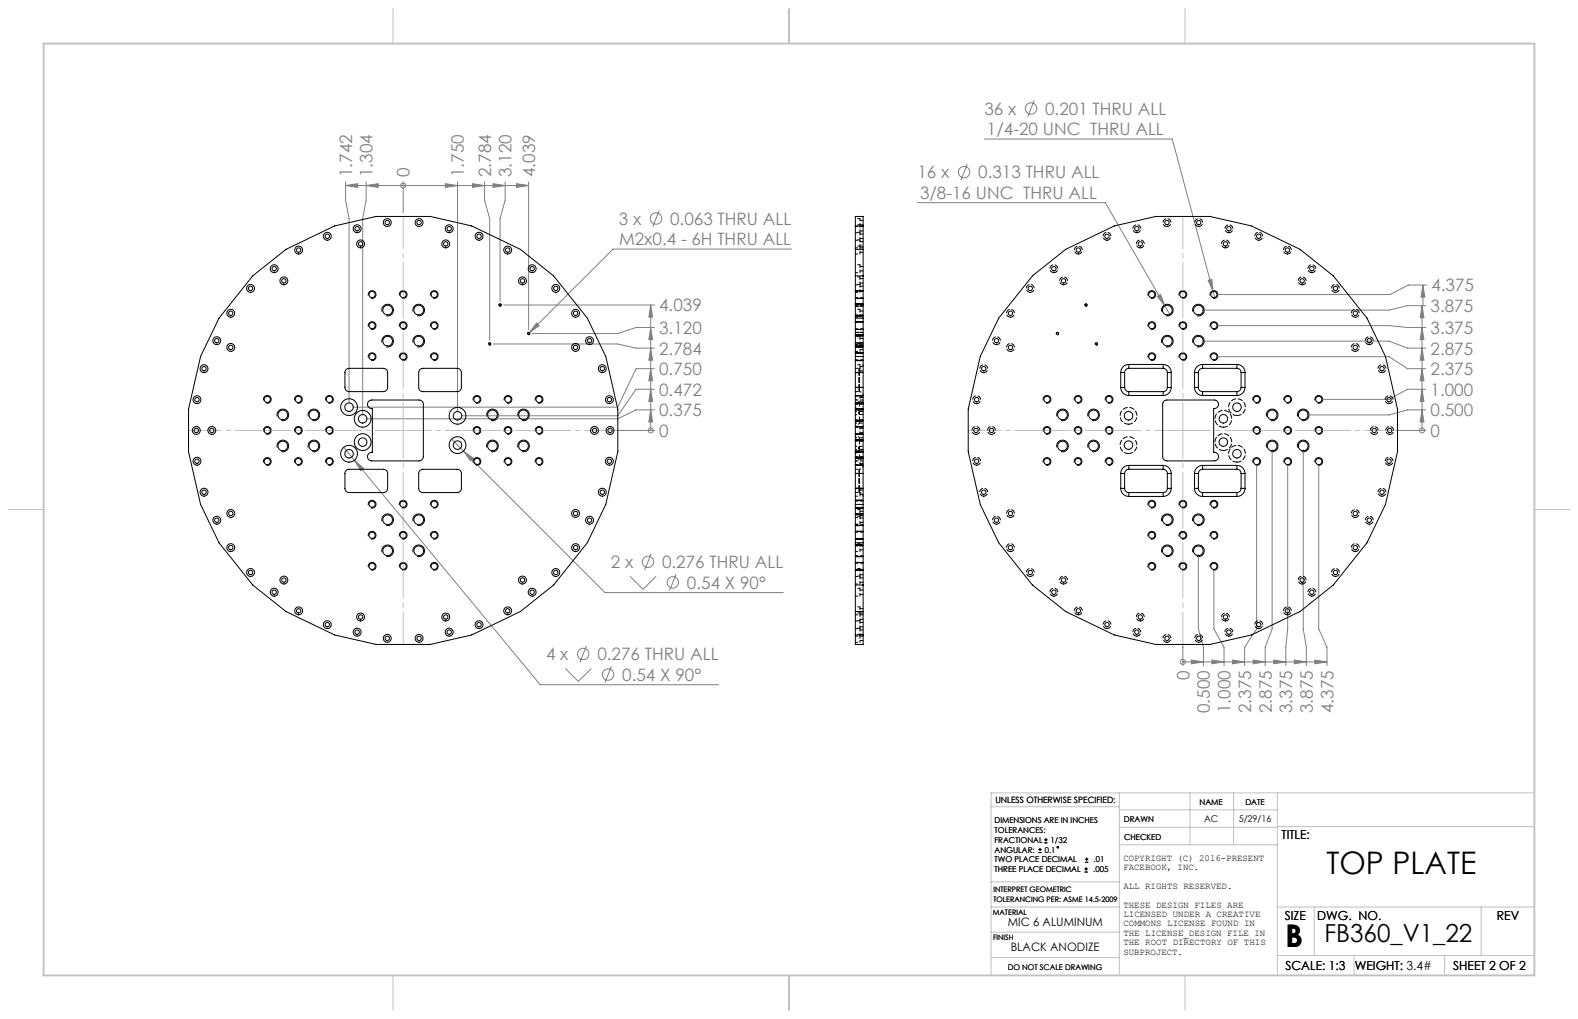
[picture p26: page 10]
0.276 THRU ALL; 0.201 THRU ALL; 0.313 THRU ALL; SCALE: 1:3; WEIGHT: 3.4#; DWG. NO.; REV; SIZE; WEIGHT:

1/4-20 UNC THRU ALL
3/8-16 UNC THRU ALL

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

CHECKED | | | TITLE: TITLE: TOP PLATE

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

INTERPRET GEOMETRIC
TOLERANCING PER: ASME 14.5-2009
MATERIAL
MIC 6 ALUMINUM
BLACK ANODIZE FINISH

8 x | 0.197 0.49
M6x1.0 | 0.38

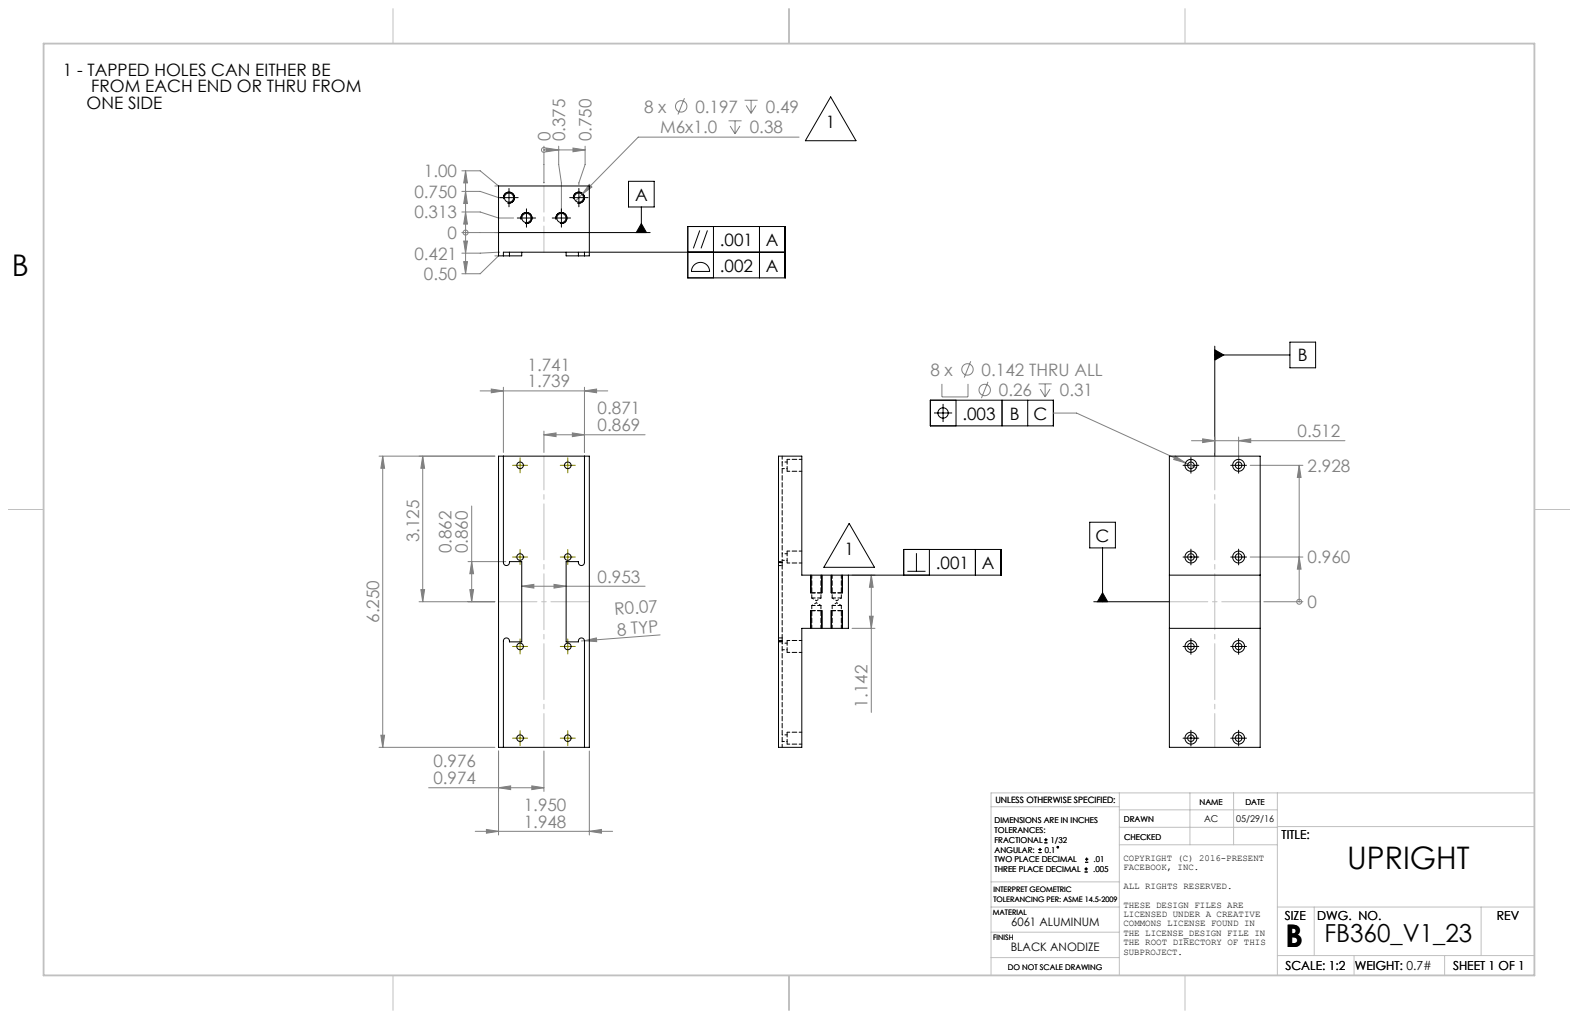
[picture p27: page 11]
0.953 R0.07 8 TYP; 0.142 THRU ALL; SCALE: 1:2; WEIGHT: 0.7#; DWG. NO.; REV; SIZE; WEIGHT:

1 - TAPPED HOLES CAN EITHER BE
FROM EACH END OR THRU FROM
ONE SIDE

.001 | A
.002 | A

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

CHECKED | | | TITLE: TITLE: UPRIGHT

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

INTERPRET GEOMETRIC
TOLERANCING PER: ASME 14.5-2009
MATERIAL
6061 ALUMINUM
BLACK ANODIZE FINISH

2.000

# 4 x 0.276 THRU ALL

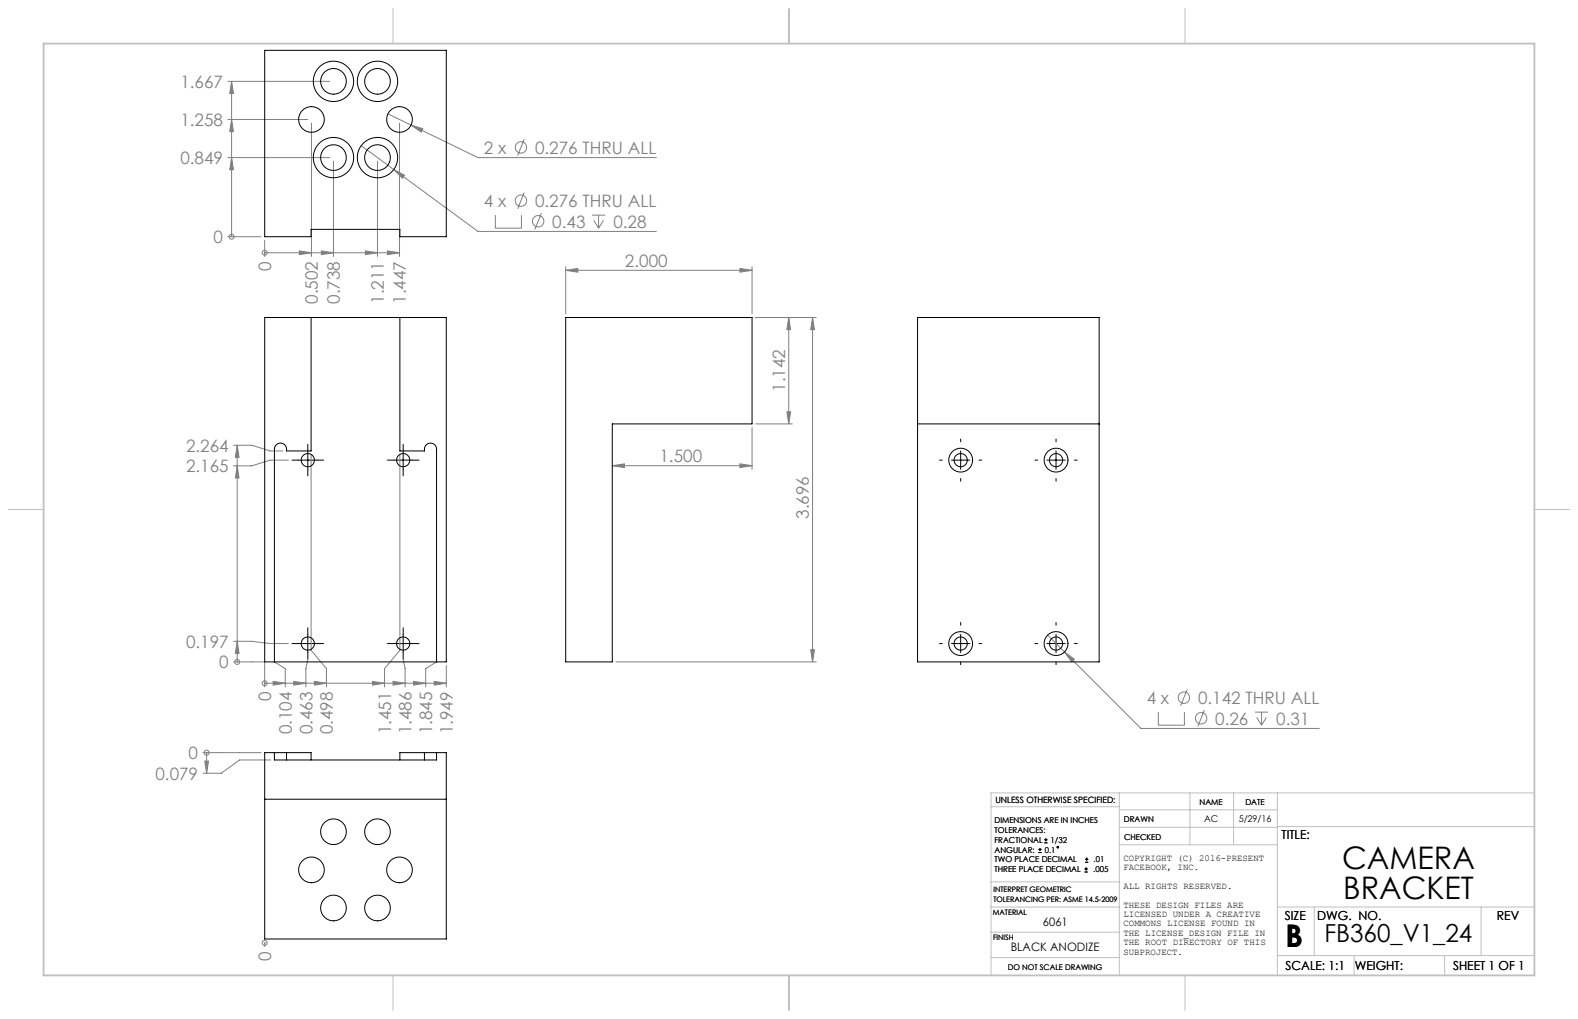
[picture p28: page 12]
0.276 THRU ALL; 0.142 THRU ALL; SCALE: 1:1; WEIGHT:; DWG. NO.; REV; SIZE

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

CHECKED | | | TITLE: TITLE: CAMERA BRACKET

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

INTERPRET GEOMETRIC
TOLERANCING PER: ASME 14.5-2009
MATERIAL
BLACK ANODIZE FINISH

6 x 0.197 0.59

# M6x1.0 - 6H 0.47

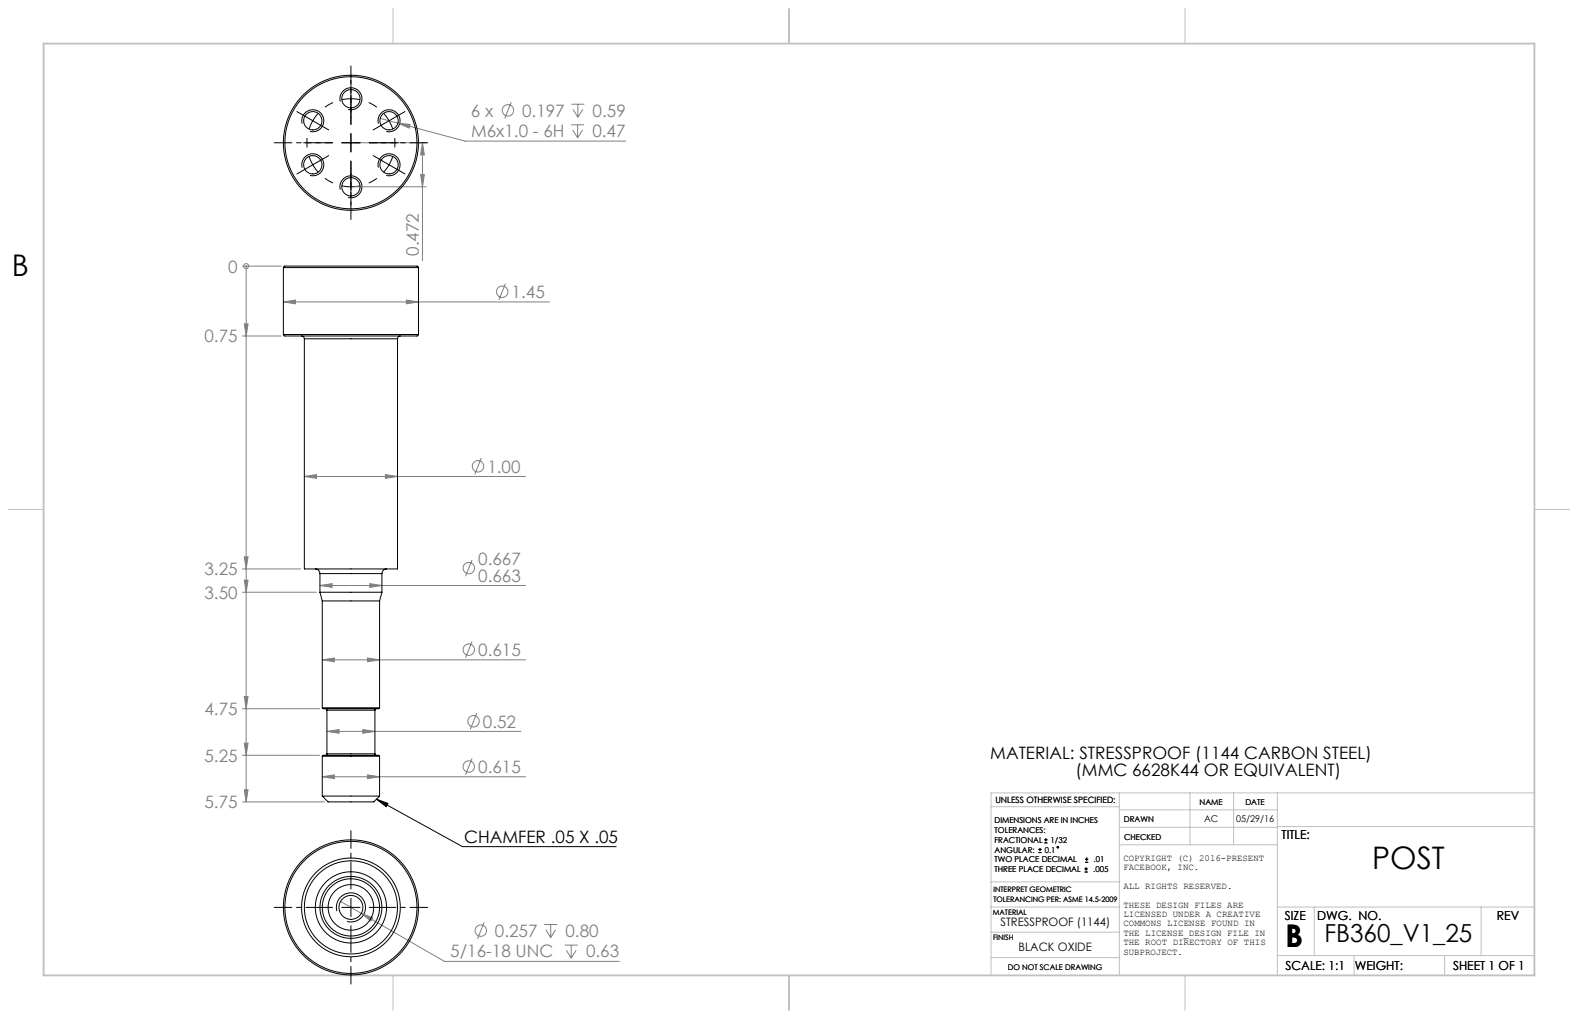
[picture p29: page 13]
CHAMFER .05 X .05; 5/16-18 UNC; SCALE: 1:1; WEIGHT:; DWG. NO.; REV; SIZE

MATERIAL: STRESSPROOF (1144 CARBON STEEL)

(MMC 6628K44 OR EQUIVALENT)

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

CHECKED | | | TITLE: TITLE: POST

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

INTERPRET GEOMETRIC
TOLERANCING PER: ASME 14.5-2009
MATERIAL
STRESSPROOF (1144)
BLACK OXIDE FINISH

A

# BREAK EDGE

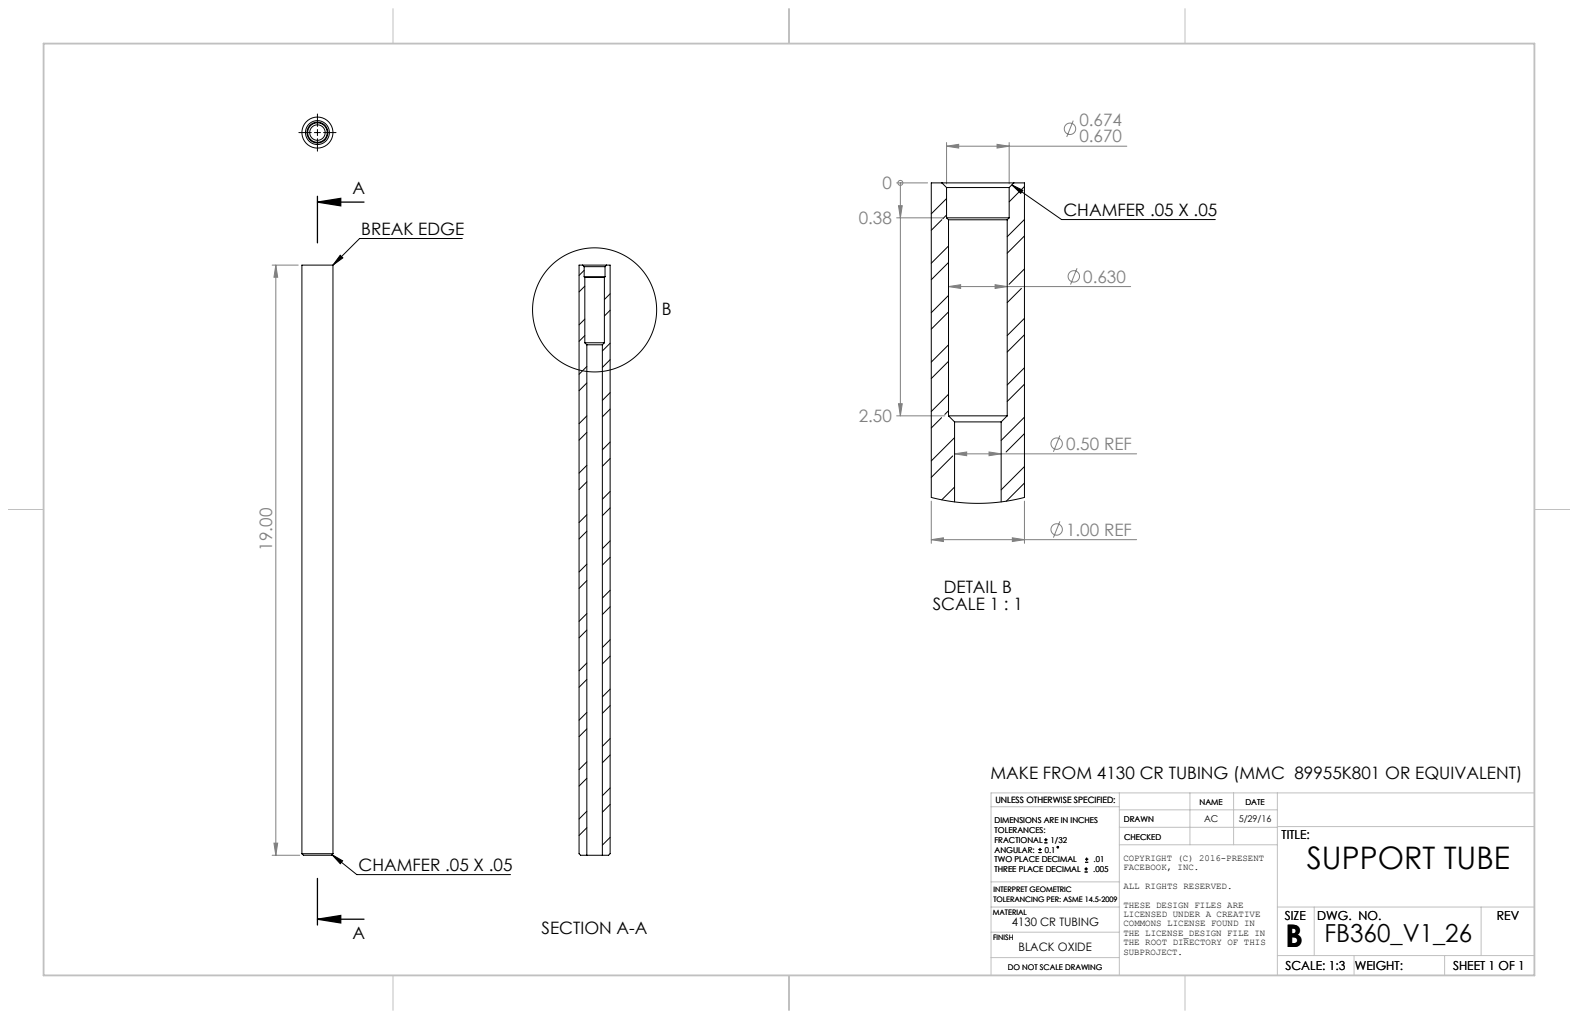
[picture p30: page 14]
CHAMFER .05 X .05; SECTION A-A; 0.50 REF; 1.00 REF; DETAIL B SCALE 1 : 1; SCALE: 1:3; WEIGHT:; DWG. NO.; REV; SIZE

MAKE FROM 4130 CR TUBING (MMC 89955K801 OR EQUIVALENT)

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

CHECKED | | | TITLE: TITLE: SUPPORT TUBE

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

INTERPRET GEOMETRIC
TOLERANCING PER: ASME 14.5-2009
MATERIAL
4130 CR TUBING
BLACK OXIDE FINISH

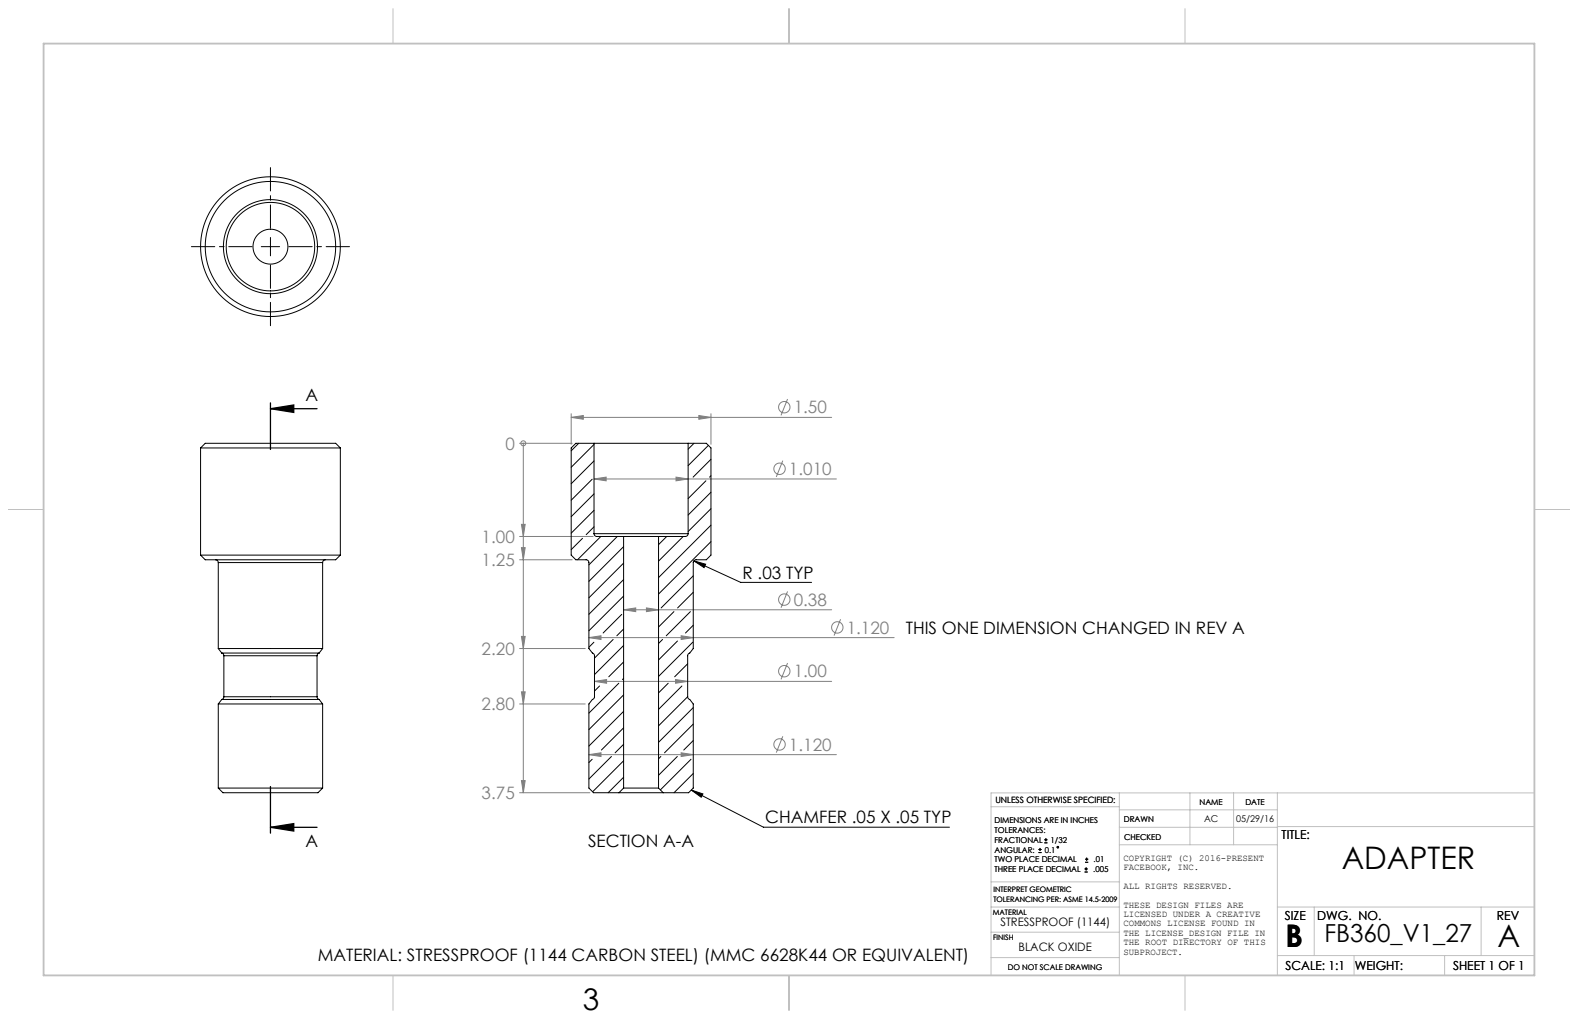
[picture p31: page 15]
SECTION A-A; CHAMFER .05 X .05 TYP; SCALE: 1:1; WEIGHT:; DWG. NO.; REV; SIZE

R .03 TYP
THIS ONE DIMENSION CHANGED IN REV A

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

CHECKED | | | TITLE: TITLE: ADAPTER

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

INTERPRET GEOMETRIC
TOLERANCING PER: ASME 14.5-2009
MATERIAL
STRESSPROOF (1144)
BLACK OXIDE FINISH

MATERIAL: STRESSPROOF (1144 CARBON STEEL) (MMC 6628K44 OR EQUIVALENT)

0.498

0.249

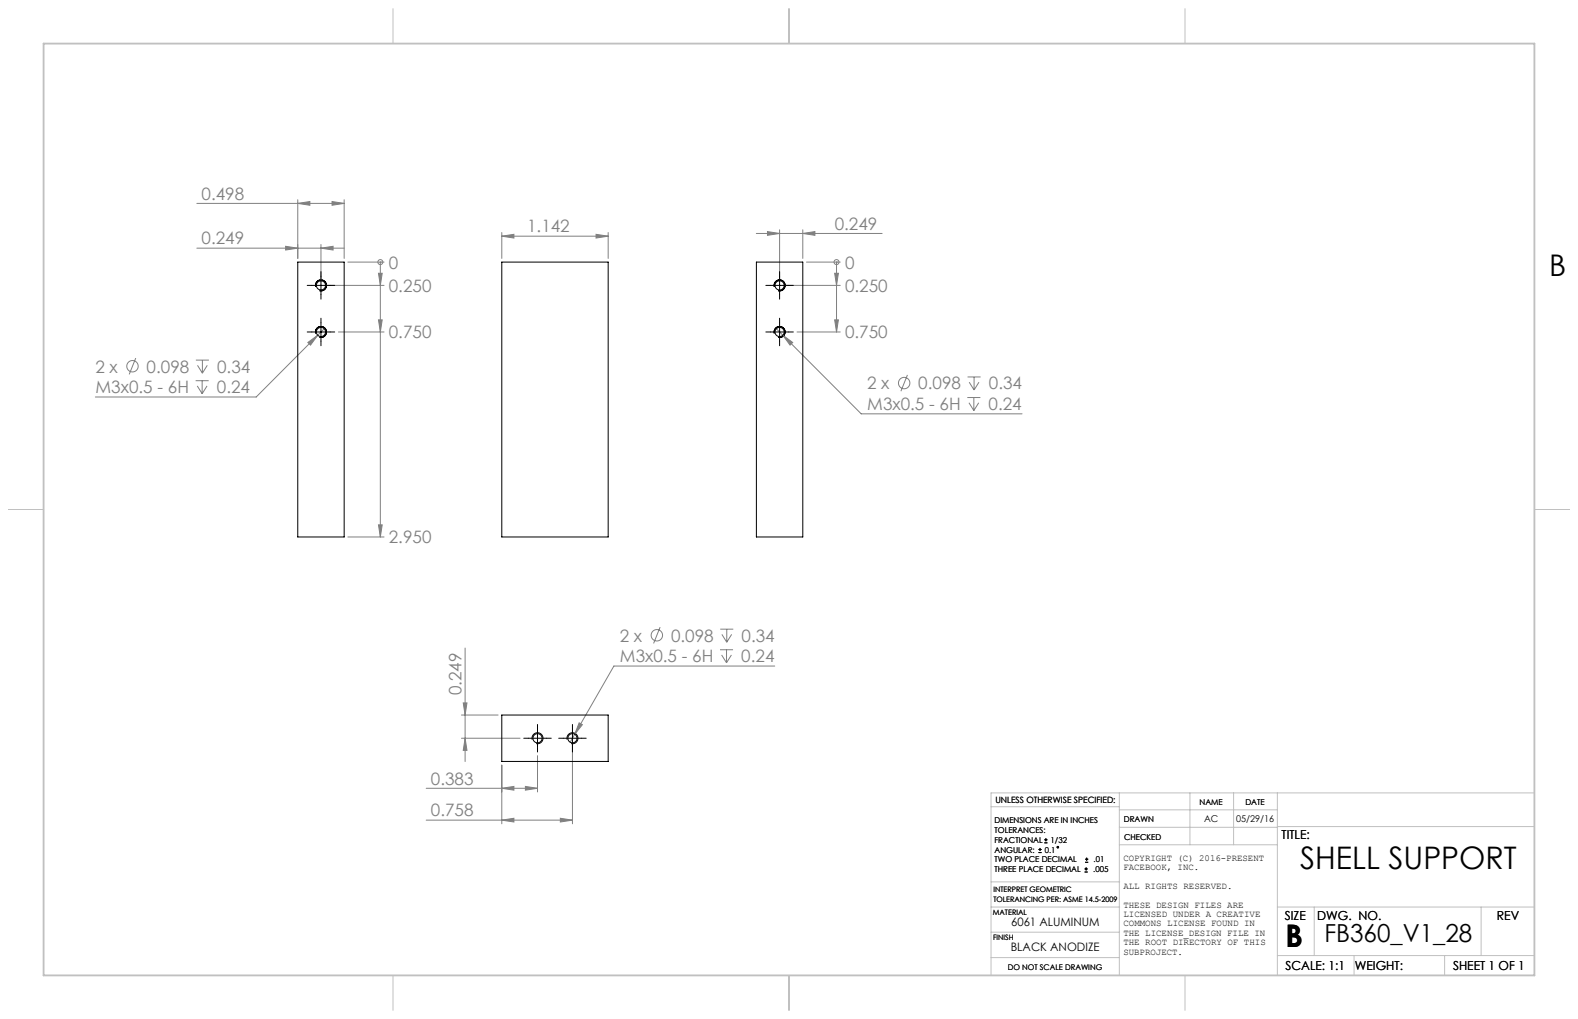
[picture p32: page 16]
SCALE: 1:1; WEIGHT:; DWG. NO.; REV; SIZE

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

CHECKED | | | TITLE: TITLE: SHELL SUPPORT

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

INTERPRET GEOMETRIC
TOLERANCING PER: ASME 14.5-2009
MATERIAL
6061 ALUMINUM
BLACK ANODIZE FINISH

0.19

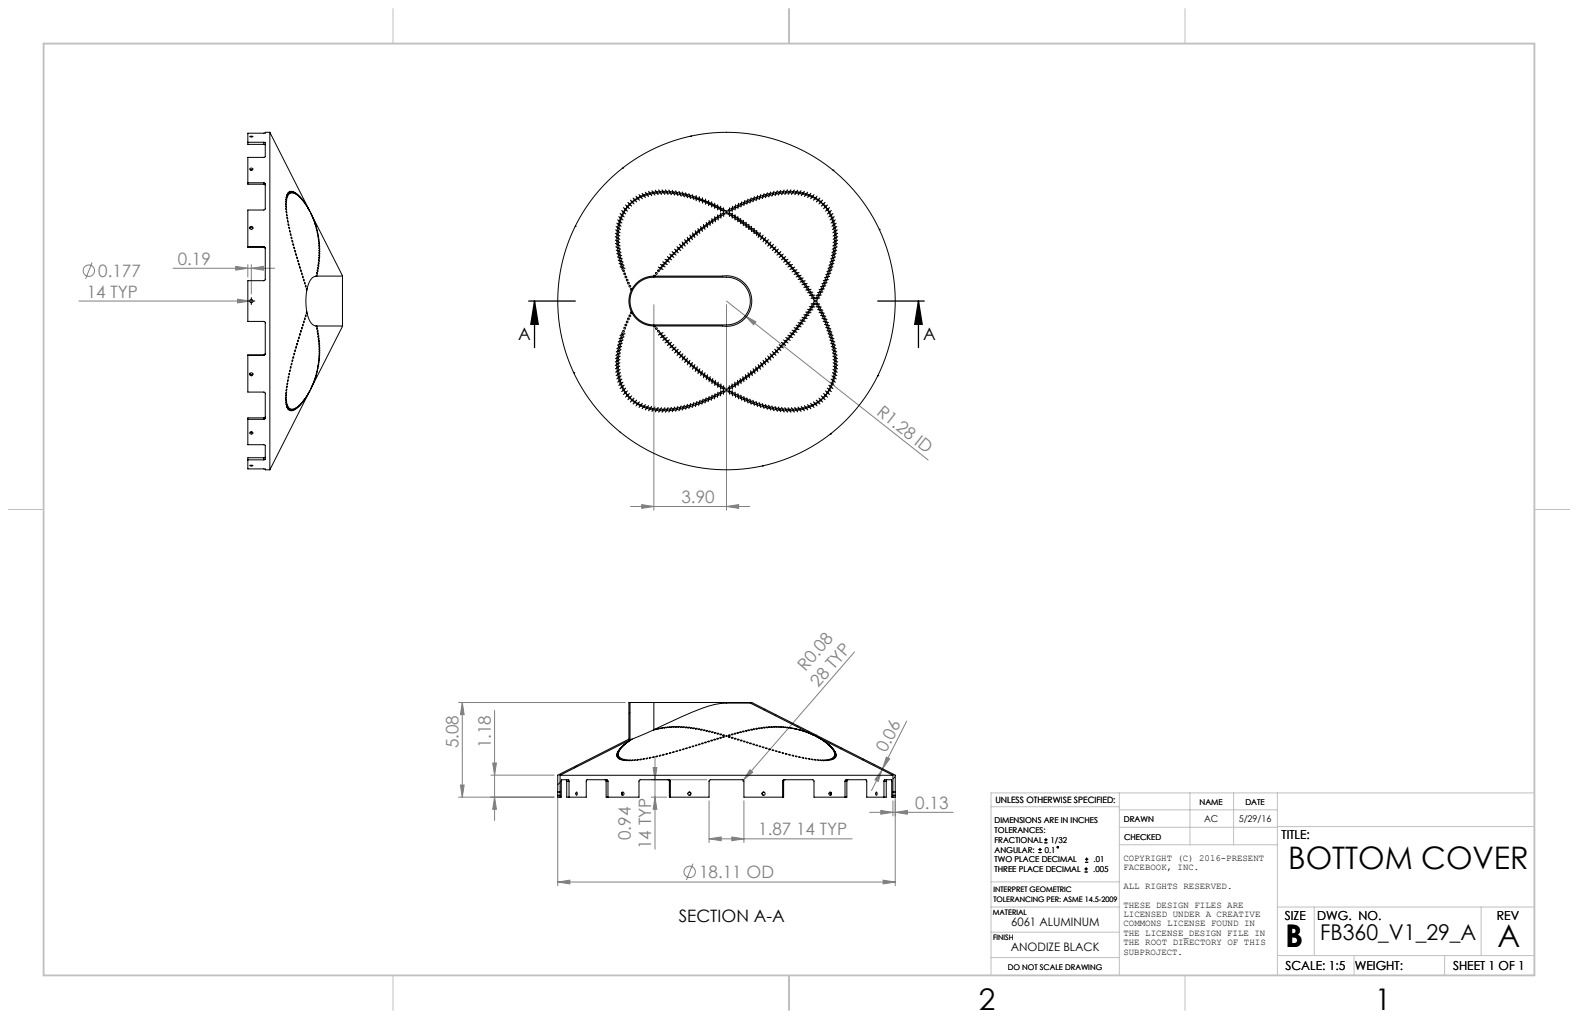
[picture p33: page 17]
1.87 14 TYP; 14 TYP; R0.08 28 TYP; SECTION A-A; 0.177 14 TYP; SCALE: 1:5; WEIGHT:; DWG. NO.; REV; SIZE

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

CHECKED | | | TITLE: TITLE: BOTTOM COVER

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

INTERPRET GEOMETRIC
TOLERANCING PER: ASME 14.5-2009
MATERIAL
6061 ALUMINUM
ANODIZE BLACK FINISH

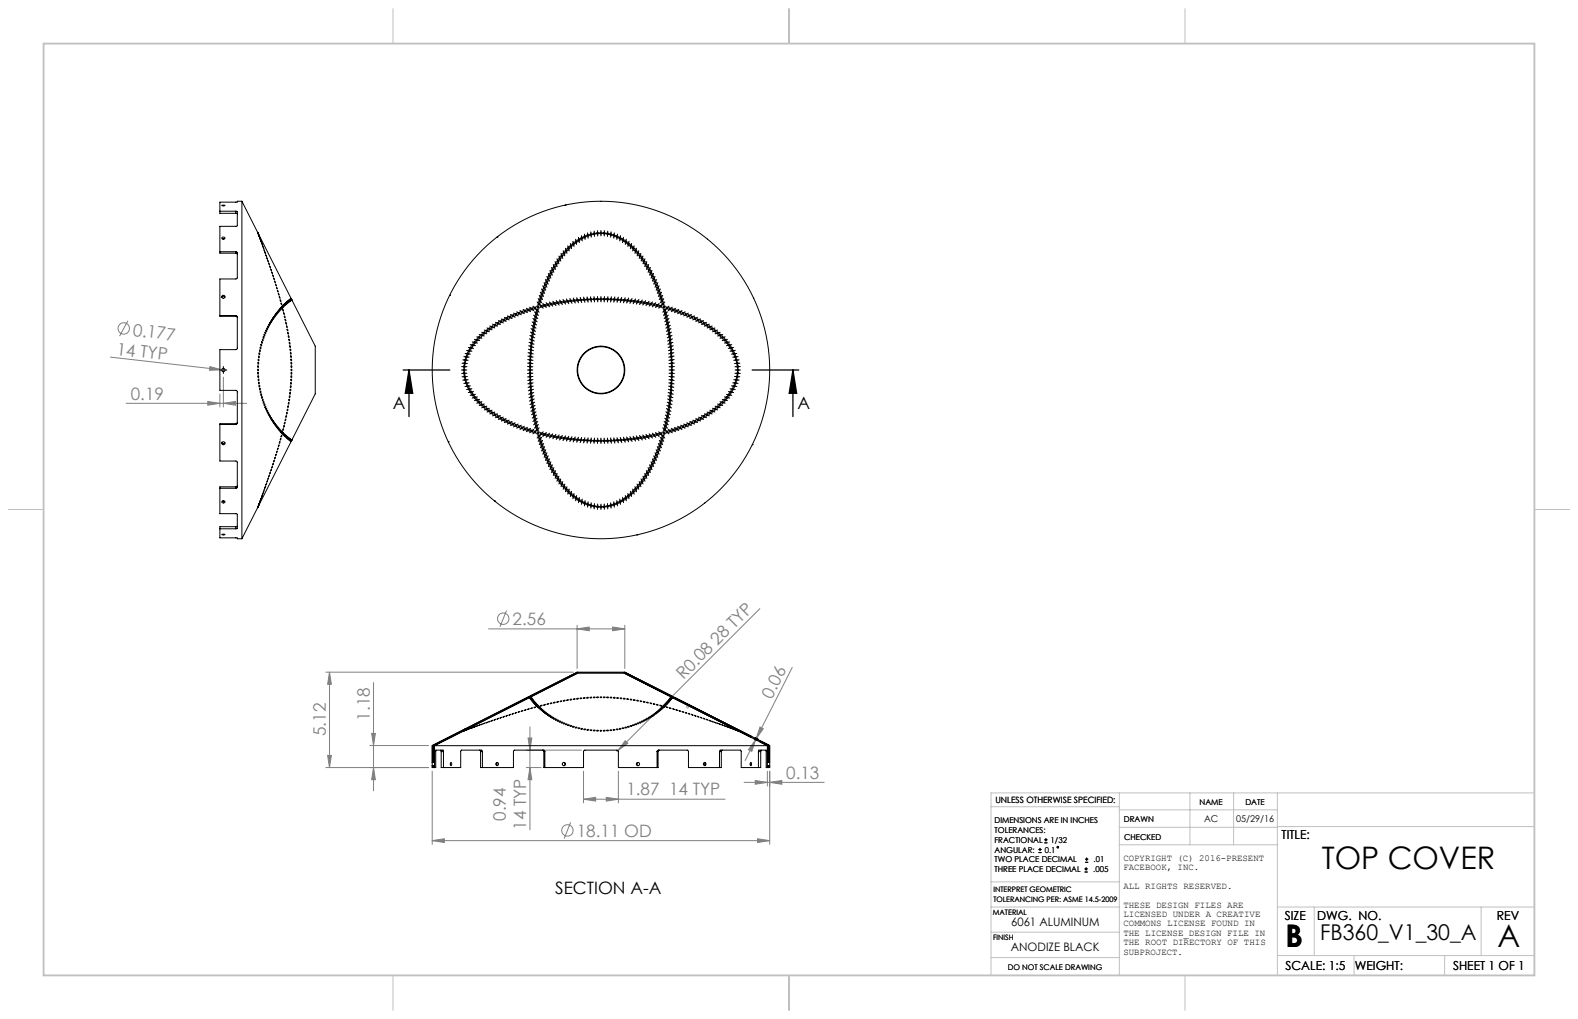
[picture p34: page 18]
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

CHECKED | | | TITLE: TITLE: TOP COVER

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

INTERPRET GEOMETRIC
TOLERANCING PER: ASME 14.5-2009
MATERIAL
6061 ALUMINUM
ANODIZE BLACK FINISH

# 0.257 THRU ALL 5/16-18 UNC THRU ALL

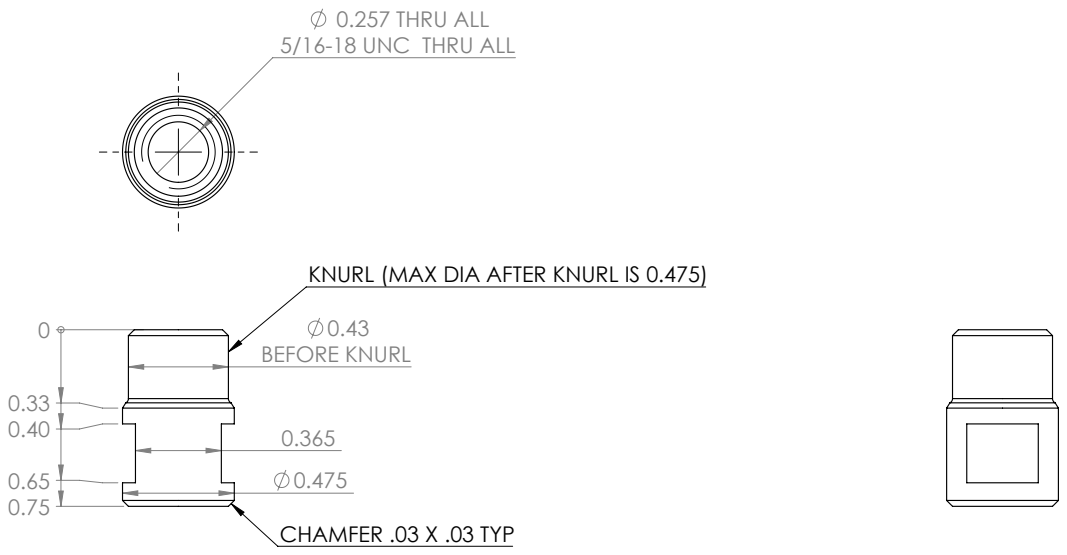
[picture p35: page 19]
CHAMFER .03 X .03 TYP; SCALE: 2:1; WEIGHT:; DWG. NO.; REV; SIZE; NONE FINISH

KNURL (MAX DIA AFTER KNURL IS 0.475)
BEFORE KNURL

UNLESS OTHERWISE SPECIFIED: | | NAME | DATE
DIMENSIONS ARE IN INCHES DIMENSIONS ARE IN INCHES TOLERANCES: TOLERANCES: FRACTIONAL 1/32 FRACTIONAL 1/32 ANGULAR: 0.1 ANGULAR: 0.1 TWO PLACE DECIMAL TWO PLACE DECIMAL .01 .01 THREE PLACE DECIMAL .005 THREE PLACE DECIMAL .005 | DRAWN | AC | 05/24/16

CHECKED | | | TITLE: TITLE: STOP NUT

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

INTERPRET GEOMETRIC
TOLERANCING PER: ASME 14.5-2009
MATERIAL
BRASS

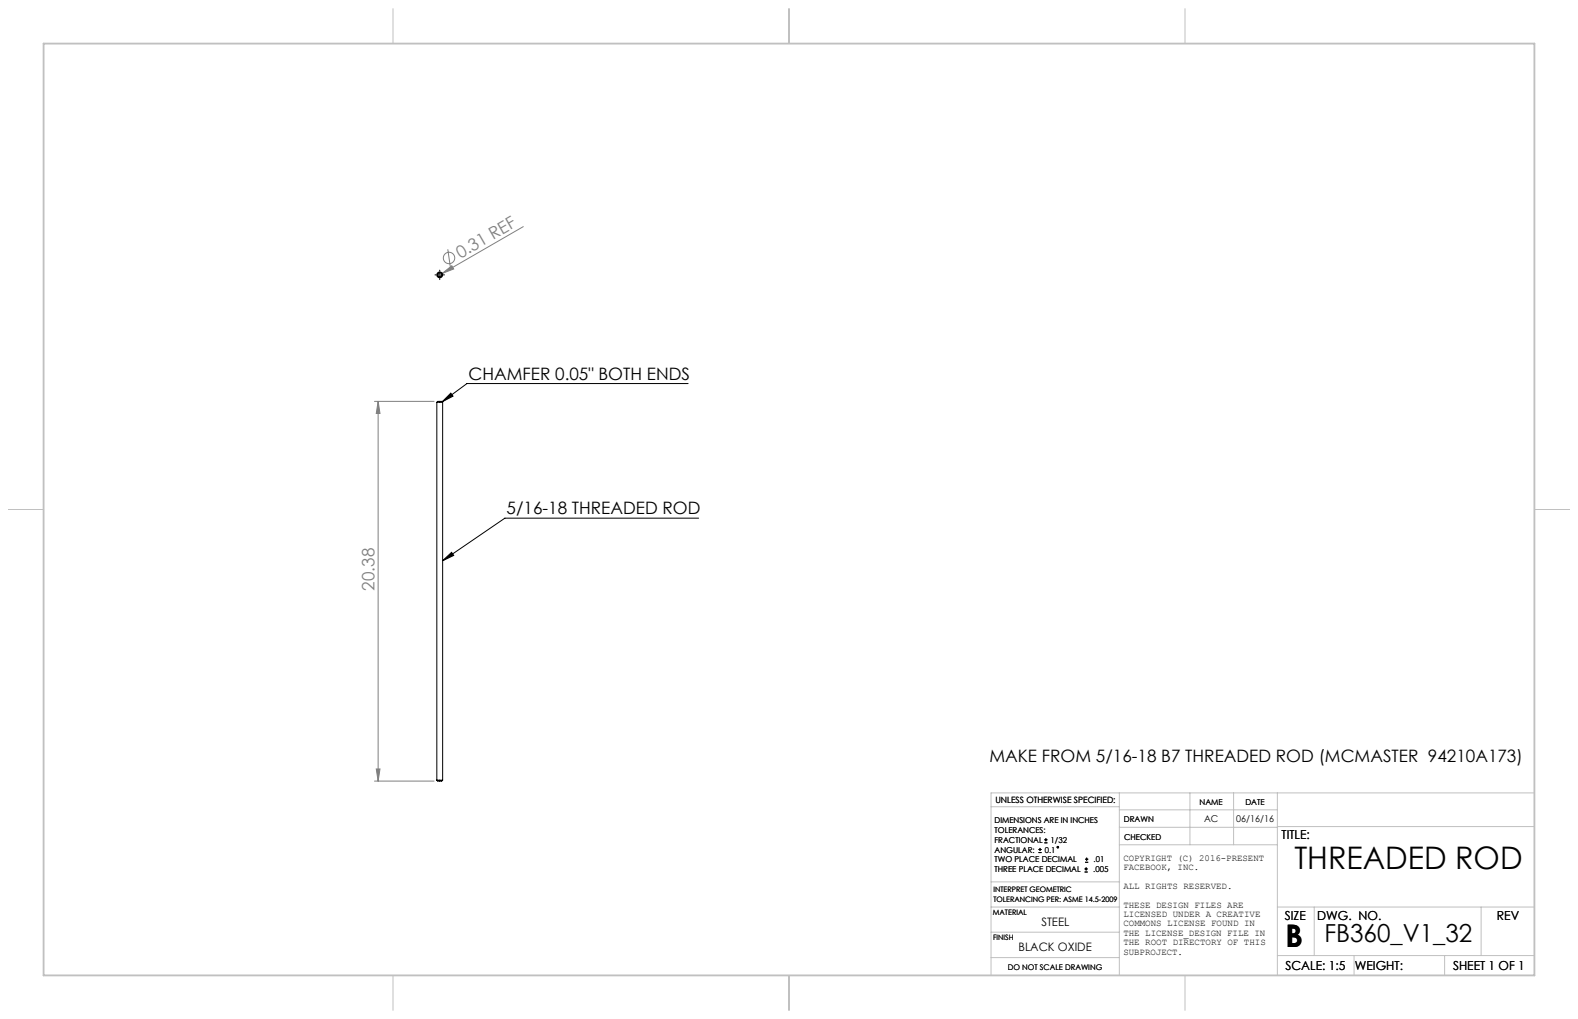
[picture p36: page 20]
5/16-18 THREADED ROD; 0.31 REF; SCALE: 1:5; WEIGHT:; DWG. NO.; REV; SIZE

CHAMFER 0.05" BOTH ENDS

MAKE FROM 5/16-18 B7 THREADED ROD (MCMASTER 94210A173)

UNLESS OTHERWISE SPECIFIED: | | NAME | DATE
DIMENSIONS ARE IN INCHES DIMENSIONS ARE IN INCHES TOLERANCES: TOLERANCES: FRACTIONAL 1/32 FRACTIONAL 1/32 ANGULAR: 0.1 ANGULAR: 0.1 TWO PLACE DECIMAL TWO PLACE DECIMAL .01 .01 THREE PLACE DECIMAL .005 THREE PLACE DECIMAL .005 | DRAWN | AC | 06/16/16

CHECKED | | | TITLE: TITLE: THREADED ROD

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

INTERPRET GEOMETRIC
TOLERANCING PER: ASME 14.5-2009
MATERIAL
STEEL
BLACK OXIDE FINISH

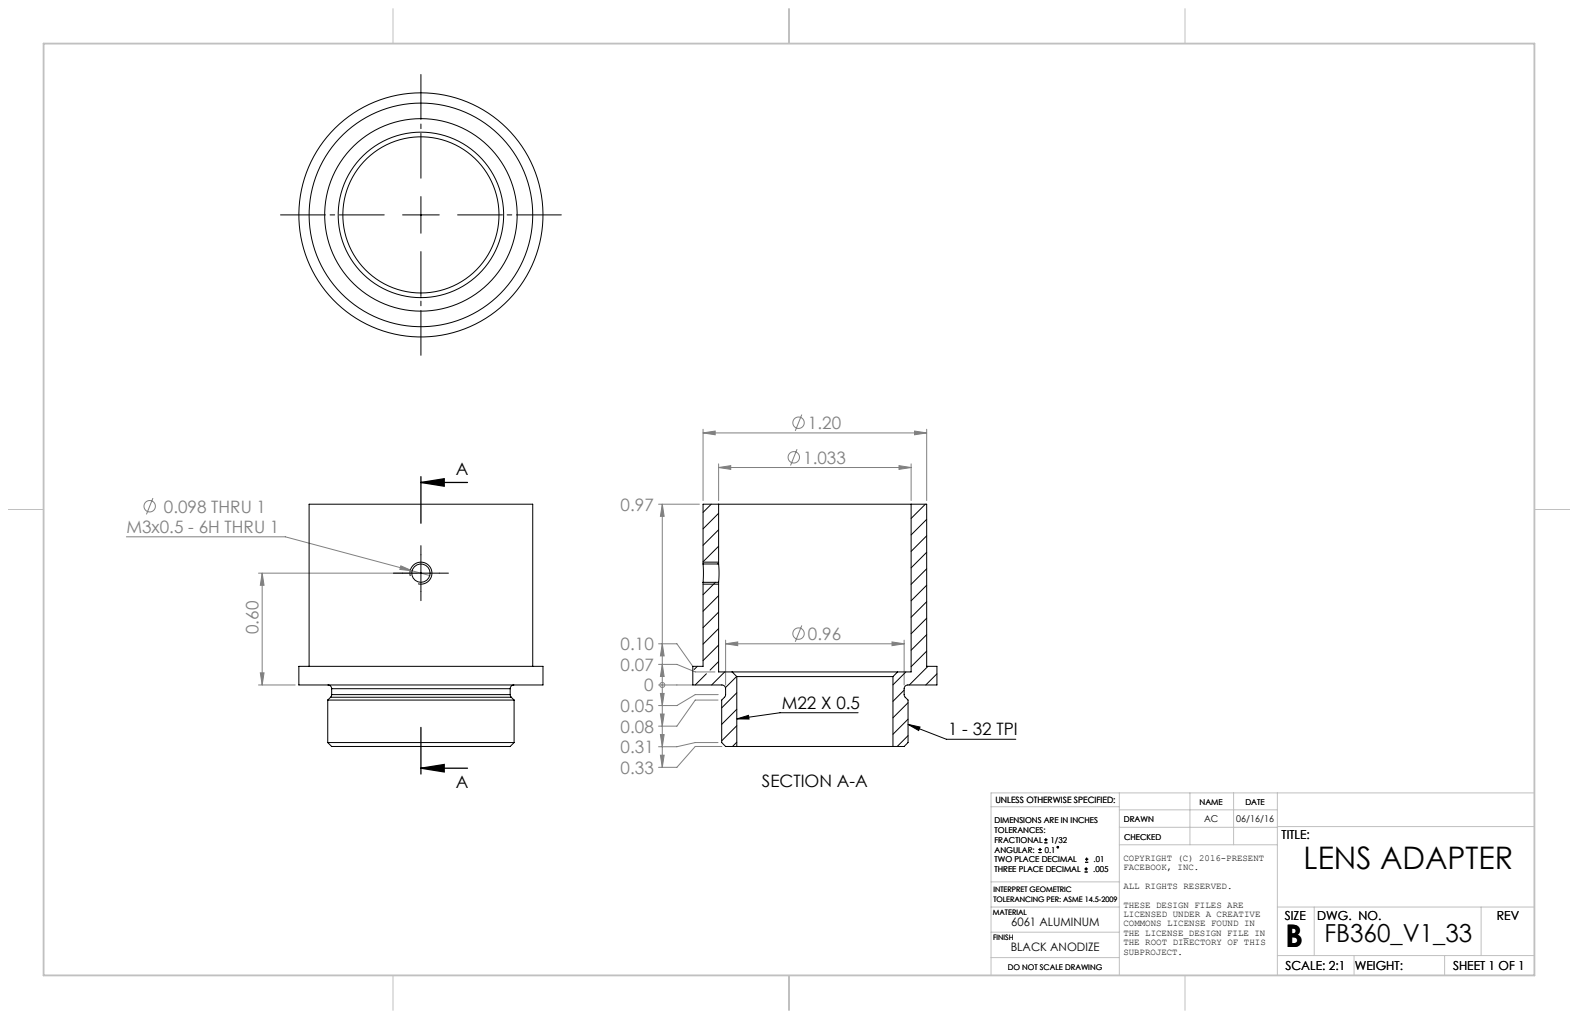
[picture p37: page 21]
0.098 THRU 1 M3x0.5 - 6H THRU 1; SECTION A-A; 1 - 32 TPI; SCALE: 2:1; WEIGHT:; DWG. NO.; REV; SIZE

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

CHECKED | | | TITLE: TITLE: LENS ADAPTER

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

INTERPRET GEOMETRIC
TOLERANCING PER: ASME 14.5-2009
MATERIAL
6061 ALUMINUM
BLACK ANODIZE FINISH

# 6" EFFECTIVE LENGTH FROM BOOT TO BOOT

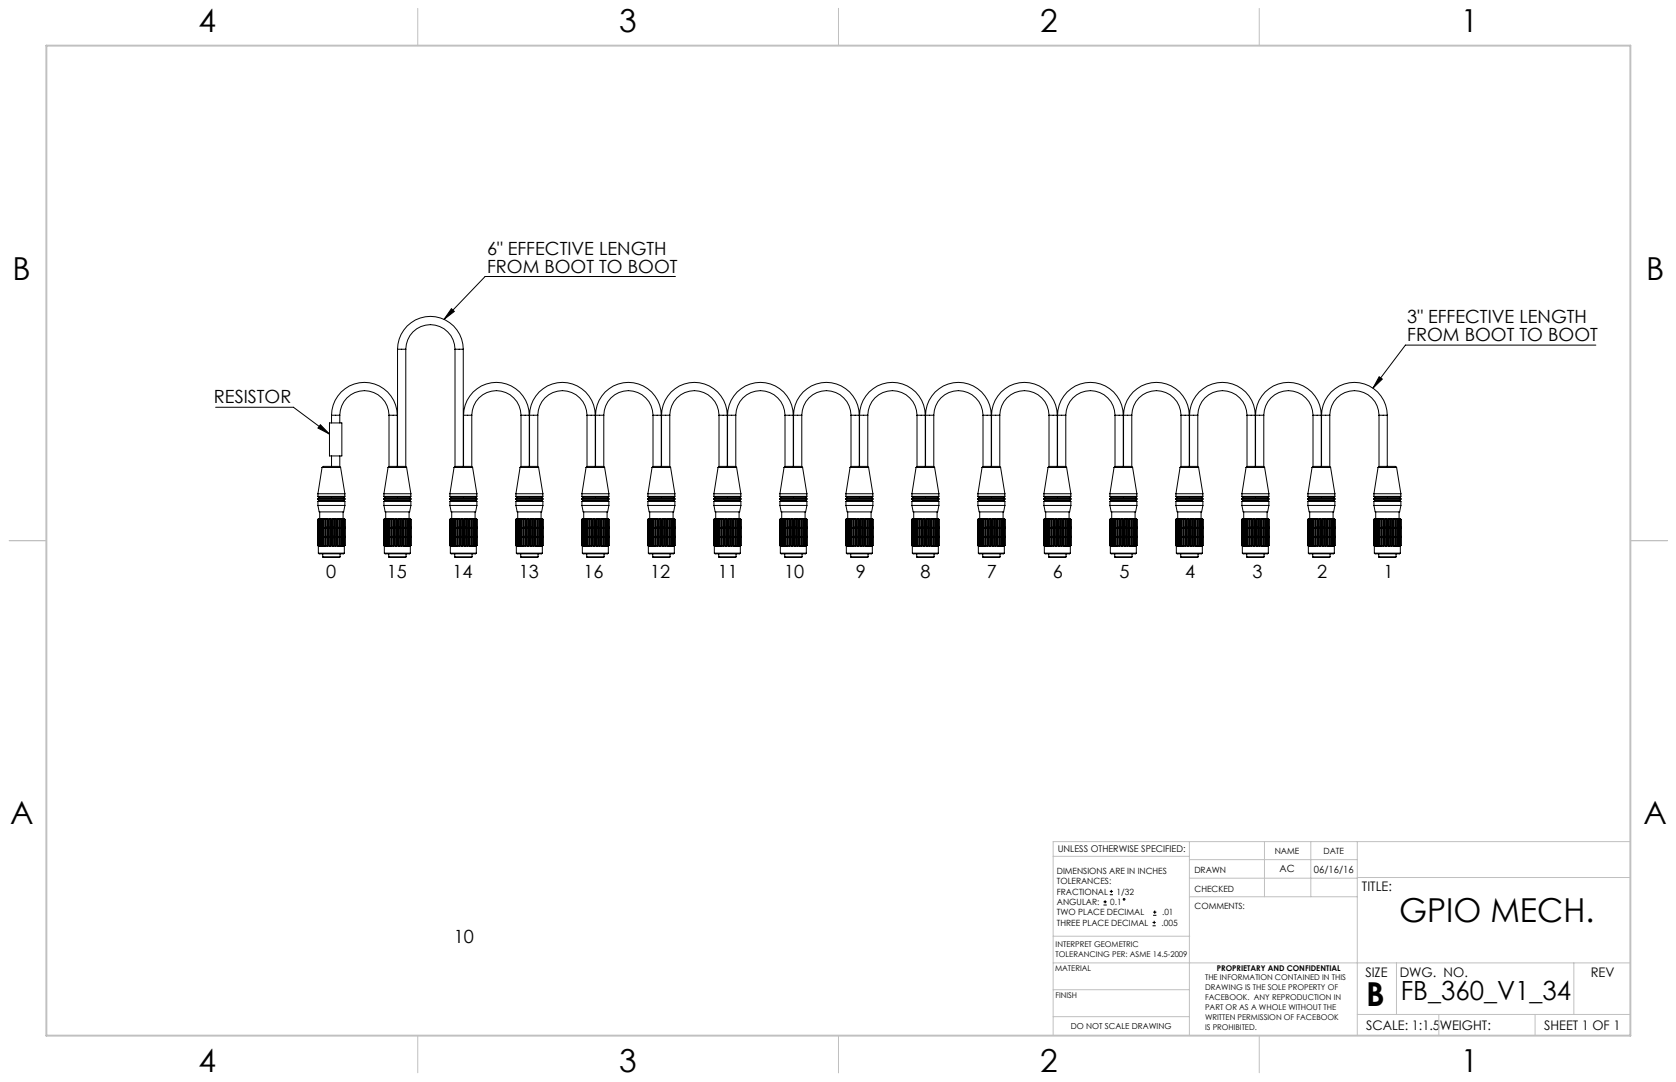
[picture p38: page 22]
RESISTOR; SCALE: 1:1.5WEIGHT:; DWG. NO.; REV; SIZE; COMMENTS:

3" EFFECTIVE LENGTH
FROM BOOT TO BOOT

UNLESS OTHERWISE SPECIFIED: | | NAME | DATE
DIMENSIONS ARE IN INCHES TOLERANCES: FRACTIONAL 1/32 ANGULAR: 0.1 TWO PLACE DECIMAL .01 THREE PLACE DECIMAL .005 | DRAWN | AC | 06/16/16

CHECKED | | | TITLE: GPIO MECH.

INTERPRET GEOMETRIC
TOLERANCING PER: ASME 14.5-2009
MATERIAL

PROPRIETARY AND CONFIDENTIAL
THE INFORMATION CONTAINED IN THIS
DRAWING IS THE SOLE PROPERTY OF
FACEBOOK. ANY REPRODUCTION IN
PART OR AS A WHOLE WITHOUT THE
WRITTEN PERMISSION OF FACEBOOK
IS PROHIBITED.
