facebookarchive/Surround360/(commit log)

2016-07-26 Initial commit
    fbshipit-source-id: 8d0501007f5d85ee9d45ecbf338743b9c854b686
    [160523_3.STEP, FB360_V1_21.STEP, FB360_V1_22.STEP, FB360_V1_23.STEP, FB360_V1_24.STEP, FB360_V1_25.STEP, FB360_V1_26.STEP, FB360_V1_27.STEP]
2016-07-26 rename git_ignore to gitignore
    Summary: - the .git_ignore files in the render and camera control subdirs shoudl be named .gitignore instead
    Reviewed By: JoelMarcey
    Differential Revision: D3622104
    fbshipit-source-id: f56ccf090b10b235853d89b218f898ba77fc371e
2016-07-26 fixed typo: gaurds->guards. removed statement about additional patent grant from camera control and design subdirectory CONTRIBUTING.md files; it is still applicable to the render subdir.
    Summary:
    - fixed a typo in the CONTRIBUTING.md file (include gaurds -> include guards)
    - removed "We also provide an additional patent grant." from the CONTRIBUTING.md files in /surround360_camera_ctl and /surround360_design; it is still applicable to /surround360_render
    Differential Revision: D3622887
    fbshipit-source-id: 27c1db0918aa9ffe9fa6293403b55c3cac4b1464
2016-07-26 Camera control - Show Stop Preview button after recording
    After recording we keep previewing, hence the need to show the button to stop preview.
    Minor change: moved `button_stop_preview` above `button_start_record` for ease of reading.
    Reviewed By: fbriggs
    Differential Revision: D3623887
    fbshipit-source-id: a23afa50f7886cb94b53b3d3c46609213b7227bc
    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
2016-07-27 Update CALIBRATION.md
    Error in the intrinsic_checkerboard.png location.
    Closes https://github.com/facebook/Surround360/pull/12
    Differential Revision: D3629272
    Pulled By: fbriggs
    fbshipit-source-id: d7c0bb53a35d6f3a8bc257db475e5e1476c4c3a2
    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
2016-07-28 no nframes
    Summary: We don't use the `nframes` argument when capturing anymore, so passing `-nframes '.$num_frames` to CameraControl will result in a failed execution.
    Differential Revision: D3633432
    fbshipit-source-id: 0b61f6e788d6be40b27e27a1c1e6ab4135170131
    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
2016-07-28 remove prefixes from .bin and cameranames
    Now that we create individual directories on every capture, there's no need for prefixes on the .bin and cameranames files.
    We still support the old format with prefixes in `<prefix>0.bin`, `<prefix>1.bin` and `<prefix>cameranames`. Note that the underscore is now part of the prefix (e.g. `123456_`).
    Differential Revision: D3632195
    fbshipit-source-id: 4736eca824f1b29d24968db4f825869d8f38e7a6
    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
2016-08-03 add link to sample data to top-level README.md
    Summary: - adds a link to top-level README.md to download a sample dataset
    Reviewed By: superdog8
    Differential Revision: D3664650
    fbshipit-source-id: 52b1c5e8ac45d91bbab6243d9dd5bdab0e52806a
2016-08-03 fix broken link to sample datset in readme.md
    Summary: - fix broken link to sample dataset in readme.md
    Differential Revision: D3664758
    fbshipit-source-id: 12c746034d12fc5177690a7617c59066318b5596
    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
2016-08-03 simplify interface to rectification
    - previously running rectification required multiple commands and a lot of manual creation of folders and copying files around
    - this diff simplifies it to a single command and eliminates all manual steps
    - adds a check after the rectification optimization completes to see if the objective is plausible. if it is very high, it suggests a problem (we have seen this once before in a case where keypoint matching failed in a low-light scene). if the objective is too high, a warning is given.
    - run_all.py now has an additional step of the pipeline called 'rectify' which does all of this automatically.
    - run_all.py checks for some common input errors, e.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
2016-08-05 auto-adjust brightness of side cameras and adjust colors of top/bottom/secondary bottom cameras to make blending smoother (in renderer, not in ISP)
    This diff adds several new features related to color correction, to create smoother transitions between images that are blended in the rendering pipeline, and reduce stereo inconsistency. there are two major additions here:
    * For the side cameras, a constant brightness offset is added/subtracted from the images. This offset is computed by finding which pixels are blended after optical flow/during novel view synthesis. Because we don't have the information we need to compute these offsets until it is already too late, the pipeline handle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
    [NovelView.cpp, NovelView.h, PoleRemoval.cpp]
2016-08-05 make color adjustment in renderer optional
    - a recent diff added automatic color/brightness adjustment to the renderer. this helps smooth blends.
    - however, it is not necessary if the ISP calibration is perfect, and it increases runtime.
    - so this diff makes the automatic adjustment optional
    Differential Revision: D3677583
    fbshipit-source-id: 1631325e6aefde1ce095df95f7c7a31f8768ce0c
    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
2016-08-08 update top-level README with CDN link and sample result
    - updates top-level README.md to use a CDN front-end for the sample dataset (which should be a faster download for non-US users)
    - also adds a link to sample results from porcessing the sample dataset
    Reviewed By: tox-fb
    Differential Revision: D3685381
    fbshipit-source-id: 6da98c10dbaa06da9902ab0a49c9b40fc3cc6a27
    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
2016-08-08 optimization: move vertical padding after flow
    - we work with equirectangular projections throughout the pipeline. prior to this diff, we would project the side cameras to equirect, then pad them to the full 180 degree vertical fov, then do flow.
    - this means a lot of the work flow is doing is applied to empty parts of the equirectangular image
    - this diff moves the padding to after optical flow.
    - this reduced the runtime to render at 6k on a MacPro from 28.475sec to 23.99sec
    - this is also one step closer to properly supporting f-theta (fisheye) lenses for side cameras, although it is not complete.
    Differential Revision: D3687290
    fbshipit-source-id: 7cbc4292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
2016-08-10 fix bug in ring rectification using only 1 frame
    - fixed a bug in TestRingRectification where it would use multiple copies of the first frame if more than one frame was supplied
    - thanks to PaulBergmann for reporting this on Github
    Differential Revision: D3697445
    fbshipit-source-id: 61d79a1e1ba7f475f7dc703b4c5d9896e525d0b2
    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
2016-08-10 fix rendering pipeline so it can handle f-theta lenses on side cameras with FOV not equal to 180 degrees
    - previously the rendering pipeline could support fisheye lenses on side cameras, but only if they were exactly 180 degree FOV f-theta lenses
    - this diff fixes some issues that occurred when trying to use f-theta lenses on the side with FOV other than 180
    - in particular, the code that projects the raw camera image to equirectangular has been changed for cameras with "is_fisheye" set to true
    - alpha blending between top and side cameras after flowing top to side has changed slightly, to address the case where flow warps the top camera upward and this pulls regions of missing data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
    [ImageWarper.cpp, PoleRemoval.cpp]
2016-08-12 dont hardcode rig radius
    - previously the radius of the camera rig was hardcoded in batch_process_video.py
    - this diff makes it a parameter defined in the rig json file
    Differential Revision: D3710239
    fbshipit-source-id: 2e69f4cf697efc521a2aeb2576a73c0d419bf550
    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
2016-08-18 adds a new mode to TestOpticalFlow which computes interpolation error on Middlebury data
    Summary: - runs an experiment to evaluate optical flow using "interpolation error" metric, on the Middlebury dataset
    Differential Revision: D3733232
    fbshipit-source-id: b0a02ba8d3a8557cc28561c2e244ba24abe4018e
    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
    [NovelView.h]
2016-08-23 ffmpeg prefixed with sequence name
    This diff adds the name of the directory containing the .bin data as prefix to the final .mp4 file.
    This was a request from the NBA post production company, because it makes it easier to track files if we render lots of sequences.
    Differential Revision: D3759610
    fbshipit-source-id: ed0f3ec605475eb9c2f25d2db547eb8067e113d0
    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
2016-08-23 Always pointing to default cam_to_isp_config file
    Even if we specify our own camera to ISP config file via `--cam_to_isp_config_file`, batch_process_isp.py always uses
    surround360_render_dir + "/res/config/isp/" + cam_to_isp_config[filename_prefix]
    as path to each ISP file, instead of the ones pointed by the specified camera to ISP config file.
    This diff solves the problem by making batch_process_isp.py expect absolute paths for each ISP file, and forcing run_all.py to also use absolute paths in `update_isp_mappings`.
    Differential Revision: D3760991
    fbshipit-source-id: cdcc93a6c7c7323fe41d9c49cc0ede4c823f5c88
    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
2016-08-24 fixed wrong default value of rig radius in 17cmosis_default.json
    - the default rig json file had the wrong radius of 15.65cm
    - this diff updates it to the correct radius of 21.8cm
    - this changes results slightly, affecting perception of size and depth
    - tests look like it is better now
    Reviewed By: aparrapo
    Differential Revision: D3767397
    fbshipit-source-id: 4d84a61fddb5390c7019579a0011de8977c9d5a5
    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
2016-08-26 improvements to fast preview
    - exposes width, height, and gamma parameters in the GUI
    - now uses the secondary bottom camera for pole removal
    - precomputes warp matrix for remap for a small optimization
    Differential Revision: D3775301
    fbshipit-source-id: cbb9d4a1bce9f480f18df3a1d7728e6fc05747d0
    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
    [ImageWarper.cpp, ImageWarper.h]
2016-08-31 Preview: change ffmpeg location
    Summary: This diff changes the assumed location of the ffmpeg executable. In `run_all.py` we assume it's on the environment path, which is more plausible than having it on the current directory.
    Differential Revision: D3795609
    fbshipit-source-id: c89d93724646a12c2f497f6feb47e2a1e6167fec
    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
2016-09-08 Color correction matrix (CCM) computation
    This diff creates a new executable, `TestColorCalibration`, that takes a RAW image containing a MacBeth chart and a SpyderCube under known illuminant, and generates an output ISP config file to be used during rendering. The procedure can be summarized as follows (also explained in #12274840):
    1) Automatically find black level (should be black hole in the SpyderCube).
    2) Passthrough RAW to RGB: removing black level offset, but or white balance gains, no stuck pixel/darkness thresholds, no denoising, no CCM, no sharpenning, no contrast/saturation adjustment, and no gamma correction.
    3) Color chart patch detection: via adaptive thresholding, m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
    [CameraIsp.h]
2016-09-08 Fix compilation error introduced by D3682267
    Summary: After D3682267 landed, a clean arc pull was failing to compile because of a duplicate symbol error caused by the non-static function `toLab`.
    Differential Revision: D3837613
    fbshipit-source-id: b9fd24fe488e673d7f9ff009907c3f145de9ff4a
    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
    [ColorspaceConversion.h]
2016-09-09 Color calibration - filter detected contours
    There were some constraints on the chessboard detector that were causing false positives, and also missing some real patches due to closeness to the border of the image, and their size when the camera is closer.
    This diff removes the constraint of ignoring the border of the image, relaxes the max area and reduces the min distance allowed between patches. It also slightly increases the block size of the adaptive threshold algorithm.
    Differential Revision: D3841772
    fbshipit-source-id: 0174b390292a5244d778f39d11779155ed0dc451
    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
2016-09-10 Color calibration - Relax black level mask
    To avoid getting false contour positives around the SpyderCube we can move it further away from the checkerboard, but the black level detector mask zeroes out 50% of the image from the center.
    This diff relaxes the black level mask to 90% instead. In any case the idea of the mask was to avoid embedded image on the borders and other junk outside the light box.
    Differential Revision: D3845532
    fbshipit-source-id: 96011be589dddba792d2624f3b434e0f56659c90
    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
2016-09-14 fix bug that was causing non-deterministic results
    rand uses a global seed
    so if you call it from two different threads, you don't get the same sequence
    which again means that you get different results every time you run your code
    that's really bad, as it precludes checking whether a change you made broke something
    it also precludes regression testing, if we want to go there some day
    anyway: this fix just uses a prng that is local to the function
    Differential Revision: D3863944
    fbshipit-source-id: 0581463c954040bf0477c47218caaf2fe265baba
    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
2016-09-17 Color calibration - dump ISPs from internal storage to capture directory
    With this diff we now pull data from the cameras' internal storage and save it to the capturing directory. Based on tox-fb's work in D3633546.
    Currently these files are ISP config files, but they can be anything we want.
    Small changes:
    - Due to a GitHub pull request that I did not manage through Facebook's Open Source Bot the change `source[i] == null` was applied to the GitHub repo but not here, so it got automatically added now.
    Differential Revision: D3844572
    fbshipit-source-id: 03ff85bc40f518afef2109b818eecd03d0b079f4
    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
2016-09-17 Reverted commit D3844572
    fbshipit-source-id: fe4c6e7bbb3c444a008be9ba7fbc65732e00fd18
    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
    [PointGrey.cpp, PointGrey.hpp]
2016-09-19 better algorithm to compute initial flow, perhaps
    at the coarsest level of the flow pyramid, the algorithm is seeded with
    zero flow everywhere. instead, perform a search in the direction specified
    by the hint to see if there is a better fit there. the default is to search
    zero percent of the smaller image dimension, effectively disabled
    it is also unlikely that the error metric is particularly good. running an
    off-the-shelf stereo matching algorithm would be interesting
    here is a comparison of pixflow_low and pixflow_low_search_low for a case where someone is standing only 2 feet from the camera
    {F62835722}
    {F62835723}
    or compare full eqr frames, before:
    {F62916292}
    after:
    {F6291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
    [NovelView.cpp, OpticalFlowInterface.h, PixFlow.h, PoleRemoval.cpp]
2016-09-24 Added a pure c-style pointer based interface to facilitate realtime preview buffers
    Summary: In order to support zero-copy, double-buffered ISP realk-time rendering this diff allows for raw buffer pointers to be setup and replaced on a per-frame basis.
    Differential Revision: D3913971
    fbshipit-source-id: d01f431ad63bb9e794fd8b0fcf749c8023a58d7d
    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
    [CameraIsp.h, CameraIspGen.cpp, CameraIspPipe.h, Raw2Rgb.cpp]
2016-10-19 fix bug: color adjustment is applied to pole removal regardless of whether it is enabled
    - there was a bug where color auto-adjustment was applied in the step where the two bottom cameras are fused for pole removal, regardless of whether or not color adjustment was enabled
    - this diff fixes the bug
    Differential Revision: D4045952
    fbshipit-source-id: 7e30349893c3870fb3dc3fb8602b840f330869c6
    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
    [PoleRemoval.cpp, PoleRemoval.h]
2016-10-26 Fixed camel-case typo in CMakeLists.txt
    Summary: Fixed cmakefile for linux
    Differential Revision: D4085255
    fbshipit-source-id: 3e6ec3f880ec5b85d76676c76052477a592fe723
    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
2016-10-27 @allow-large-files Add desktop app for camera control.
    This is a new version of a control app, this time computing everything locally
    and not sending video through ffmpeg, but rather using our ISP and displaying
    images from cameras via OpenGL to a GTK window region.
    Differential Revision: D3982394
    fbshipit-source-id: 8ce7a4c4e12e4e3ae0ebb591916a2eb7b70a0ae7
    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
    [FB360_V1_21.STEP, FB360_V1_22.STEP, FB360_V1_23.STEP, FB360_V1_24.STEP, FB360_V1_25.STEP, FB360_V1_26.STEP, FB360_V1_27.STEP, FB360_V1_28.STEP]
2016-10-28 Fix preview cam selection dropdown ordering to match camera listing order.
    Summary: see above
    Differential Revision: D4093662
    fbshipit-source-id: ce2b86db0ff606d421846340216a26cc2616a16d
    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
    [CameraController.cpp, CameraView.cpp, CameraView.hpp, PreviewCamComboBox.cpp, ShutterComboBox.cpp]
2016-11-02 Added missing clamp to the Halide version.
    Summary: You need to clamp after white-balance and black-level gains to deal with partially saturated pixels.
    Differential Revision: D4117465
    fbshipit-source-id: c27d5895723c6eefa9825335c58a77a5488ea5d0
    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
    [CameraIspGen.cpp]
2016-11-05 Updated color calibration: robust detection + multi-camera adjustments
    This diff updates the color calibration procedure to include new features:
    - Script to automatically calibrate set of cameras and generate ISP config files
    - Improved colorchecker detection: cross-shaped morphological elements to close checkerboard boundaries, scale image to highlight differences between patches and boundaries, Gaussian blur to aid adaptive thresholding
    - Compute RGB response of each sensor to get black level and white balance gains. Not using SpyderCube anymore, and white balance forces response to match grounf truth data
    - Adjust all cameras to worst dynamic range, by applying clamping and con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
2016-11-07 Noise-robust black level computation
    Currently our automated method for black level computation just picks the darkest pixel from the input image (ignoring image borders for metadata). Even though we assume we have a black hole (e.g. SpyderCube), the lowest value could be affected by noise.
    With this diff we now get the black level (again assuming we have a black hole) from channel histograms. We pick the lowest non-zero value (ignoring dead pixels) with enough pixel count to avoid outliers (i.e. noise).
    Differential Revision: D4140603
    fbshipit-source-id: 4d0db2a91042ebb3d66d62db22daa98ed0025cb4
    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
2016-11-07 Fix an out of bounds access, drive by whitespace / indentation fixes
    Summary: see title
    Differential Revision: D4094948
    fbshipit-source-id: 110e800e63e5671620c2cdd3d490cab8bf5630d9
    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
    [AlignedAllocator.hpp, CameraController.cpp, CameraController.hpp, CameraDiscoverButton.cpp, CameraDiscoverButton.hpp, CameraListModel.hpp, CameraListView.cpp, CameraListView.hpp]
2016-11-07 Added README.md for camera control desktop app
    Summary: README.md file
    Differential Revision: D4141807
    fbshipit-source-id: 4aef620950c59632160a263738b892f6f33f3fc4
    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
2016-11-09 Set white balance to off by default
    We used to fix a white balance to a known value to turn
    auto-whitebalance off. this time we explicitly turn off any kind of
    analog white balancing in the camera.
    Differential Revision: D4154860
    fbshipit-source-id: 05f879bb7a131b4682a64a9f25dc981ee2d0aa61
    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
    [PointGrey.cpp]
2016-11-09 Make default black levels 16-bit and rename passthrough ISP config file
    The new ISP works exclusively in 16-bit, so the default black levels should be in the range [0..2^16-1].
    Also, the passthrough ISP config file is independent of sensor and lens model.
    Differential Revision: D4147498
    fbshipit-source-id: b68630170c76c6e54f4d45708a88dfbb9b705cfa
    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
2016-11-10 Read 12-bit images properly using CV_LOAD_IMAGE_ANYDEPTH
    OpenCV's `imread` function has always ben loading images as 8-bit regardless of the original depth, so we were losing precision when calibrating and running the ISP.
    By using the flag `CV_LOAD_IMAGE_ANYDEPTH` we can now load 16/32-bit images.
    Differential Revision: D4160400
    fbshipit-source-id: 4339b88ee5859518a86ecde1e24ddd28083f1650
    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
2016-11-11 Fix compiling err
    To fix compiling err:
    source/test/TestColorCalibration.cpp:119:52: error: ‘istream_iterator’ is not a membe
    r of ‘std’
    Closes https://github.com/facebook/Surround360/pull/133
    Differential Revision: D4165979
    Pulled By: aparrapo
    fbshipit-source-id: ba34f67a1e40bd9ca9180601edc3fdd043a4cf29
    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
2016-11-11 Make multi-camera black level detection more robust
    In D4140603 (Noise-robust black level computation) we assumed the black level is the lowest non-zero value with enough pixel count (to avoid noise and dead pixels). This is not always true, specially when working with12-bit images. The pixel values in a black hole are more granular, so we need to to a median.
    To make it more robust, we first use the histogram approach to find a black level threshold. This gives us a mask of pixels that are candidates to black level. We discard outliers assuming that the black hole is circular, and then we pick lowest median values of all remaining candidates.
    Also, we add a new feature in the col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
2016-11-14 Save black level median to file
    Saving the black level median to file, not just printing it.
    Also, saving debug images by default on the first calibration step, so we can see where the black level was found.
    Differential Revision: D4176390
    fbshipit-source-id: 7fc85ff911f2294555a15282854ccb0b7d0dc534
    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
2016-11-15 Add histogram display and fix a race condition that sometimes occurs
    This diff adds a histogram overlay on top of preview,
    as well as fixes a race condition that sometimes occurs when
    a user switches bit depth of the camera while preview is running.
    This causes USB packet descriptors to be unmapped from memory and
    pointers get invalidated at random points in time while various parts
    of the program are using the frame data.
    Differential Revision: D4179334
    fbshipit-source-id: 22a9a5ee9ee68585e7e6eb5c39016a0c206684a2
    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
    [CameraController.cpp, CameraView.cpp, CameraView.hpp, Shaders.cpp, Shaders.hpp]
2016-11-15 run_all: beautify step list
    Tired of having to type the pipeline steps every time and realizing you spelled "rectify" wrong for the hundredth time? Now the steps are selected via checkboxes.
    When running it from the command line we will use `--steps_unpack --steps_arrange --steps_isp --steps_render --steps_ffmpeg` instead of `--steps unpack,arrange,isp,render,ffmpeg`.
    Differential Revision: D4170486
    fbshipit-source-id: 2c9d747bd338121fd3a22f74bc9078a347e154d0
    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
2016-11-16 Add metadata header writing to the binary files
    Each binary file now comes with a metadata header explaining
    how many cameras' frames are in the file, bit depth, timestamp, and
    frame resolution information.
    Also comes with a fix for aligned_allocator when rebinding it
    Differential Revision: D4180424
    fbshipit-source-id: cda019d5d2f5fbaf05208922adc1b3184f34737e
    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
    [AlignedAllocator.hpp, CameraController.cpp, CameraController.hpp, CameraView.hpp]
2016-11-21 Compared various results and put gradient lerp back in.
    Summary: I carefully compared the c++ and Halide versions and they are doing the right thing so I don't see a lurking bug per se. I also believe the lerp version looks better with real data so I'm putting that back the way it was. I am seeing a fair bit of chroma ringing and I need to see if that is in the optics or the demosaicer. But that will be handled in a different diff no matter the source.
    Differential Revision: D4210708
    fbshipit-source-id: 98dcb51224850157308a94a879f435051520107d
    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
    [CameraIsp.h, CameraIspGen.cpp, Raw2Rgb.cpp]
2016-11-21 Unpack without cameranames.txt. Storing and reading metadata on binaries
    Currently the capturing software saves .bin files and a cameranames.txt file every time. This txt file tells us in what order the frames were written, so if we give the image width and height, and the bit depth to the unpacker it knows how to extract the data.
    After D4094948 (Fix an out of bounds access, drive by whitespace / indentation fixes) we had the serial numbers "burned" as metadata on each frame, but we still needed cameranames.txt to know the camera ordering.
    This diff adds new functionality to the capturing software so we just create the .bin files, and the unpacker so we don't need cameranames.txt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
    [CameraController.cpp, CameraController.hpp]
2016-11-21 Update main README.md to show updated path to camera_ctl_ui
    Summary: `surround360_camera_ctl2` -> `surround360_camera_ctl_ui`
    Differential Revision: D4215212
    fbshipit-source-id: ae007ddecb34c4b3685ee92c926a7fd3b1e44552
    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
2016-11-21 Update README files and rename new camera control software @allow-large-files
    This diff updates all the README files with all the necessary steps to install `surround360_camera_ctl`, `surround360_camera_ctl_ui` and `surround360_render` from scratch. Ubuntu 16.04 LTS is now fully supported.
    Markdown has also been updated. `<pre>` tags were not formatting things properly (e.g. ignoring `<foo>` tags).
    Modified `surround360_camera_ctl_ui/CMakeLists.txt` so it can see Halide when installed via cmake.
    Also renamed `surround360_camera_ctl2` tp `surround360_camera_ctl_ui`, which is more meaningful.
    Minor changes:
    - Removed `-Dinteger=int` from `surround360_render/CMakeLists.txt`. It is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
2016-11-23 mlock() memory to avoid paging, pre-emptively page-in/allocate with memset on startup
    when creating a consumer-producer buffer, allocate memory,
    and then immediately memset it, to force allocation and mlock the
    ranges to avoid pages being paged in/out which reduces performance
    Also reduces trips to cameras by re-enabling serial number caching,
    adds support for writing to two different destinations for different
    consumers, and disables preview on record start
    Differential Revision: D4227094
    fbshipit-source-id: 2e556eb412f7c63f5001fdbfa3a7f3acb421090e
    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
    [CameraController.cpp, CameraController.hpp, MainWindow.cpp, PointGrey.cpp, PointGrey.hpp, ProducerConsumer.h]
2016-11-30 ISP clamping in Halide
    The color correction method introduced not long ago used two new ISP fields: `clampMin` and `clampMax`. They are used in an additional step called `clampAndStretch` in `CameraIsp.h`, but not in the Halide version.
    This diff adds this feature to the Halide version, as part of the `demosaic` step.
    From the original equation on the non-Halide version:
    (((x - minRaw) * wb) / (maxRaw - minRaw) - clampMin) / (clampMax - clampMin)
    = ((x - minRaw) * wb - clampMin * (maxRaw - minRaw)) / ((maxRaw - minRaw) * (clampMax - clampMin))
    if we define
    rawRange = maxRaw - minRaw
    we get
    ((x - minRaw) * wb - clampMin * (maxRaw - minRaw)) / ((maxRaw - minRaw) * (clampM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
    [CameraIspGen.cpp, CameraIspPipe.h]
2016-11-30 Add copyright headers
    Summary: This diff adds copyright headers to files that didn't have them. Mostly python scripts, php files and a some C++ files.
    Differential Revision: D4218428
    fbshipit-source-id: 00bbf8ddde24509ab3cf616a53b66f2e048d48e0
    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
    [AlignedAllocator.hpp, Camera.hpp, CameraController.cpp, CameraController.hpp, CameraDiscoverButton.cpp, CameraDiscoverButton.hpp, CameraIsp.h, CameraIspGen.cpp]
2016-12-06 Bugfix to increase the lifetime of a frame vector object so that it exists when needed.
    The vector can get freed too early resulting in incorrect memory
    accesses to addresses that are no longer valid.
    Differential Revision: D4253917
    fbshipit-source-id: 5a9cec0857f84dbcf6b856fca0c99ff344d66752
    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
    [CameraController.cpp]
2016-12-06 Unpacker percentage when single camera
    When capturing and unpacking a single frame from a single camera we get a floating point exception when trying to get the percentage progress:
    int percentDoneCurr = frameIndex * 100 / frameIndex;
    with `frameIndex = 0` and `frameIndex = 0`.
    For display purposes we can just start frame counts at 1.
    Differential Revision: D4282701
    fbshipit-source-id: 71044dcde218880437b0568c01b684aab1ee7d9a
    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
2016-12-08 raw2rgb output image resized properly
    `Raw2Rgb` always create an output image of the same size as the input image, regardless of the values of the `resize` flag.
    Fixed it.
    Differential Revision: D4289750
    fbshipit-source-id: 9d58ef9cee44afb274c818710f2b856dec8e6b86
    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
    [Raw2Rgb.cpp]
2016-12-08 Pass chart area bounds to detectColorChart
    When we want to detect charts of different sizes we want to set different bounds on their size.
    This diff makes `minAreaChart` and `maxAreaChart` parameters we pass to `detectColorChart`, se we can modify them from outside `ColorCalibration`.
    - `kMaxRatioAreas` for black level hole detection relaxed to support distortions on fisheye lenses
    - Deducing `minAreaPatch ` and `maxAreaPatch ` from `minAreaChart` and `maxAreaChart`, and the total number of patches
    - Patch masks defined by any contour, not a rotated bounding rectangle
    - Removed assumption that chart is centered. After extensive testing I realized it doesn't give any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
2016-12-12 Make chart area thresholds visible to user/script
    When taking pictures of color charts for color calibration we may get too far/close, use different types of charts, etc. so I think it's a good idea that we make the expected min and max chart areas visible to the user, and to the `color_calibrate.py` script.
    - Also adding `num_squares_w` and `num_squares_h` to `color_calibrate.py` to accept other chart formats
    - Making size of morphological element used for dilation, closing, and small object removal dependent on `minAreaChart` and `maxAreaChart`
    Differential Revision: D4306491
    fbshipit-source-id: 8c880c60a49c3b046b4b63143b434fdb5d263410
    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
2016-12-15 Bezier-based vignetting correction
    This diff improves the current Bezier-based vignetting correction to support dimension separability, and corrects a bug that was causing the vignetting function to stretch when the frame is not square.
    Also, it makes the Bezier surface be centered around the center of the image, so the indices are easier to work with.
    The default ISPs are also modified to reflect these changes.
    Differential Revision: D4288642
    fbshipit-source-id: 71cba9736fa4c1451ec07f6a3a6d233228a5b9c7
    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
    [CameraIsp.h, CameraIspPipe.h, CameraView.cpp]
2016-12-15 Bezier surface generation from data points
    This diff introduces `TestVignettingCalibration`, which takes as input a set of data points and generates the closest multi-channel, separable fourth order Bezier surface.
    The main purpose of this is to generate surfaces for vignette removal, the points on the input file are supposed to be samples that model light falloff.
    The input file is assumed to be a json file with the following format:
    [
    {
    "location" : [x1, y1],
    "rgbmedian" : [r1, g1, b1]
    },
    ...
    {
    "location" : [xN, yN],
    "rgbmedian" : [rN, gN, bN]
    }
    ]
    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
2016-12-28 Filtering cleanup + noise coring
    Summary: Made a number of small changes to cleanup our filtering and fine grained image quality.
    Differential Revision: D4368864
    fbshipit-source-id: 517c20cfbe106cc7224aa1c0af17e317c517e55e
    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
    [CameraIsp.h, CameraIspGen.cpp, CameraIspPipe.h]
2016-12-30 Color calibration: Lab + joint optimization
    This diff modifies the current color calibration to introduce two new approaches:
    - Use Lab optimization for CCM computation, instead of RGB: Lab is perceptually uniform, which has nonlinear relations intended to mimic the human eye response.
    - Jointly optimize for black level, white balance, and CCM: we can get closer to the ground truth by letting all the ISP parameters fluctuate. Advantage: less steps, so less prone to accumulated error.
    A possible disadvantage of jointly optimizing for all parameters is that the black level is supposed to be a preset parameter by the sensor manufacturer, but we're letting the optimizer find the best v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
    [CameraIsp.h, CameraIspGen.cpp, ColorspaceConversion.h]
2016-12-31 Fixed a reflection/mirrow off-by-one error and a variety of otehr small buglets in filtering.
    Summary: This fixes along standing bug/difference between the halide sharpening code and the c++. The original c== was wrong in a number of ways including an off-by-one error in the "reflect" math util function.
    Differential Revision: D4375527
    fbshipit-source-id: 905b410c242e4a4413a0744c031f40d5907eacf5
    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
    [CameraIsp.h]
2017-01-03 fix debug build
    there is no identifier named bitsPerPixel
    i don't know where the code came from, so i can't figure out what it should be
    just delete the line?
    i suggest using CHECK/CHECK_EQ/etc to avoid this unless you really need the
    assert's code-is-removed-in-release-mode functionality
    Differential Revision: D4378229
    fbshipit-source-id: dd005c63b9e85916189e250b1be7c756e569b8d5
    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
    [Raw2Rgb.cpp]
2017-01-04 add new Camera class
    add support for new camera class and json format to surround360
    nothing should change for the old json format
    Differential Revision: D4354175
    fbshipit-source-id: c694254320250fef859b6227529cc9860fde8b76
    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
2017-01-12 implement pole removal for Camera
    also command line arguments and replace them with values computed from Camera
    there used to be 4 parameters which are now computed like so:
    - side_camera_h_fov_deg. this is now internally computed as the angle between forward() and the ray through the middle of the left edge. or the right edge, whichever produces the smaller angle
    - side_camera_v_fov_deg. same as above, but for top/bottom
    - pole_camera_fov_deg. now computed using getFov()
    - pole_camera_crop_fov_deg. now computed as the middle of the overlap between the side and the pole camera (or the hemisphere, whichever is smaller)
    with the checked in rig file, this corresponds to:
    - side_camer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
    [PoleRemoval.cpp, PoleRemoval.h]
2017-01-17 @allow-large-files [s360][vignetting] Data acquisition
    This diff adds files and scripts to process acquired data for vignetting calibration.
    All the steps on how to acquire the data and run the scripts are documented in CALIBRATION.md.
    - Updated color calibration steps on CALIBRATION.md
    - Updated vignetting defaults in passthrough ISP json file
    Differential Revision: D4364932
    fbshipit-source-id: e449adcfae997902184d749b9fcefc0c564d3345
    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
2017-01-19 Remove cameranames.txt for good
    Summary: We have already tested capture + unpacking with metadata embedded in the binaries. We don't need to save `cameranames.txt` anymore.
    Differential Revision: D4432082
    fbshipit-source-id: bf818326c10ba21c9c6b2b90ff4c2d2d6ecd0cfd
    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
2017-01-19 Add flash read and write methods to pointgrey camera.
    Add Tox's flash read and write methods from a different repo
    to lay foundations for reading of ISP config from camera.
    Differential Revision: D4426332
    fbshipit-source-id: 690deb0507158796bd8aa787f94914d3715fd906
    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
2017-01-20 Improve frame retrieval to avoid invoking flycapture::Image::~Image() destructor in case it releases frame buffers.
    - Improve frame retrieval to avoid invoking flycapture::Image::~Image() destructor in case it releases frame buffers.
    - Replace synchronization via std::mutex with proper C style pthread_barrier_t
    - Turn off std::iostream<->stdio synchronization
    - Add readFileAtIndex(uint32_t) method for reading files from camera flash
    - Embed more info into the frame metadata
    - Improve frame retrieval to avoid invoking flycapture::Image::~Image() destructor in case it releases frame buffers.
    Differential Revision: D4437710
    fbshipit-source-id: 583f70b2b121ed24a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
    [Camera.hpp, CameraController.cpp, CameraController.hpp, CameraView.cpp, PointGrey.cpp, PointGrey.hpp, PreviewButton.cpp, main.cpp]
2017-01-31 Improve performance of frame processing
    Improve how the memory buffers for the camera are allocated
    paying attention to memory alignment. With proper memory alignment,
    the buffers can be simply remaped when writing to external storage,
    instead of copying from user to kernel address space before the write occurs.
    This allows us to remove copying of data coming from camera entirely.
    This diff also includes drive-by refactorings and cleanups.
    Differential Revision: D4440606
    fbshipit-source-id: cc308cd4057cb06809019fbc01ac014128c2d45d
    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
2017-01-31 add geometric calibration to surround360
    tool that produces an accurate description of the rig geometry
    inputs are:
    - an approximate description of the rig geometry
    - a set of feature matches between all the cameras in the rig
    Differential Revision: D4412390
    fbshipit-source-id: 8f8a9df02db0fb260f2a44e643cb6479400e44ef
    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
2017-02-01 Script for feature extraction and matching, and geometric calibration
    Using COLMAP (https://colmap.github.io/) for feature extraction and matching. We make system calls to get a database of matches first, which we parse to a json file that `GeometricCalibration` can read.
    Everything is on a python script, so that we can perform geometric calibration with a single call to `geometric_calibration.py`.
    Differential Revision: D4479227
    fbshipit-source-id: 20e7538d7aabd95ea1cbbf40a2e617c8eae26efc
    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
2017-02-01 Add D65 illuminant to color calibration
    This diff adds ground truth values, white point and Bradford-adapted matrix for D65 illuminant.
    - Made black level num pixels threshold a flag
    Differential Revision: D4480714
    fbshipit-source-id: 1a5493c61e035b8188f953791c79215c4ca62ef6
    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
2017-02-02 use single fov for all side cameras
    generateRingOfNovelViewsAndRenderStereoSpherical expects the projection
    images to all be the same size
    so instead of computing per-side camera fovs, use the max of all side cams
    Differential Revision: D4498979
    fbshipit-source-id: 6a440f8253ecd915e58ffa8fa15d4b9b2dfd63a4
    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
2017-02-02 Fix a spurious free() on buffers that don't get allocated until init()
    When the camera is initialized, we allocate the buffers
    for frame storage. Those buffers aren't allocated until the
    camera is configured before starting capture. It is an error
    to free() them during a constructor without checking
    if the buffers are allocated in the first place.
    Differential Revision: D4503234
    fbshipit-source-id: a07691509f4518ef69604675eac34c70d4ae947a
    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
    [PointGrey.cpp]
2017-02-02 Fix sizing of a buffer
    When replacing magic numbers with constants
    few numbers escaped unchanged.
    Differential Revision: D4503758
    fbshipit-source-id: 537c062209a0b0100f6c01d88465b34702230f8a
    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
    [PointGrey.cpp]
2017-02-07 Code refactoring and semantic cleanup.
    Summary: The initialization was lazily done on pull in getImage was was just semantically broken. This diff fixes that malfeasance.
    Differential Revision: D4523373
    fbshipit-source-id: b4d4a68122fdf975193c81ac093c5efb6d5a285a
    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
    [CameraIspPipe.h]
2017-02-11 Fixes initialization order problem.
    Summary: loadImage must come before initPipe() and setup() since these routines need the input image dimensions.
    Differential Revision: D4549076
    fbshipit-source-id: 4c7e21aa508af83230c3b98bb00501cdf6b6ee0f
    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
    [CameraIspPipe.h, Raw2Rgb.cpp]
2017-02-14 Reorganize file structure
    This diff changes the file structure of the render output. Why?
    - People prefer having data organized by cameras, rather than frames. So instead of having render/vid/<frame_number>/isp_out/cam[0..16].png, we can have render/rgb/camN/<frame_number>.png. With this we don't need `make_single_cam_vid.py` anymore.
    - Having data stored by frames required having an "arrange" step to move unpacked data around to have it on the desired format. This step will not be needed anymore.
    - The workflow was getting messy with all the config files pointing to different places. Now we require all the necessary files for rendering to be on the output directory. Else we copy t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
2017-02-14 Update README files
    Summary: Adding a couple of dependencies that are necessary in some Ubuntu versions. Also updating GRUB defaults for better and more reliable capture performance. Added some comments for Halide installation, and fixed the brew command to install CERES.
    Differential Revision: D4542427
    fbshipit-source-id: 713ec4241539fb05431b8716ff615af8da9ba4a0
    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
2017-02-14 Add a new unpacker that operates on frames in memory.
    Add a basic raw data unpacker that slurps frames into memory.
    It also modularizes the previous approach and replaces file reading
    with mmap() call.
    Differential Revision: D4539284
    fbshipit-source-id: 1cc9f6a6cd00a70c8b57b487bbe6e4ac36425454
    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
    [BinaryFootageFile.cpp, CameraIsp.h, CameraIspGen.cpp]
2017-02-14 Fix ISP bug
    Summary: A couple of variables were being redefined and it was causing wrong outputs.
    Differential Revision: D4560864
    fbshipit-source-id: ac2b69225c7dd656e28da94cc2958931af2155a7
    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
    [CameraIspPipe.h]
2017-02-14 Rename dirs after unpack. Fix indentation.
    Summary: Rename directories after ordinal numbers rather than camera serial numbers
    Differential Revision: D4561514
    fbshipit-source-id: 52ca7c2a8902f07e7c63cc75887f325010c02f3e
    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
2017-02-15 New unpacker fixes
    We can now compile on OSX
    Frames are stored following %06d convention.
    Differential Revision: D4563822
    fbshipit-source-id: a230be5555c5d4d3e02a5d37cde039b1081b0239
    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
2017-02-15 Accommodate serial number-based ISP config files
    Summary: We will start naming ISP config files after each camera serial number. This diff accommodates for that change, and updates README files to point out how to name the files.
    Differential Revision: D4563851
    fbshipit-source-id: dbb6129e9d2bbb1a81ce196d4501faec16b9b268
    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
2017-02-15 Remove render color adjust
    Summary: With the new color calibration this is not needed anymore.
    Differential Revision: D4559017
    fbshipit-source-id: 83ba01649d9e31bf7a78bb386c45e95e465d1b73
    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
2017-02-15 simplify frame numbering
    Summary: make frame numbering simpler
    Differential Revision: D4568405
    fbshipit-source-id: 06c0937528bba2dfce220ed44a167ce41f039c73
    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
2017-02-16 Calibration fixes
    This diff fixes some issues with calibration procedures after some of the modules they depend on have slightly changed. Functionality and results are not changed.
    - If feature matcher does not produce matches for a specific image pair we ignore it and go to the next one, instead of stopping the calibration procedure.
    - GeometricCalibration had been accidentally removed from CMakeLists.txt. Putting it back.
    - Default black level hole pixel number is int, which is not automatically converted to string when nothing is passed.
    - Magic number set to 16 in Raw2Rgb.cpp
    - Recent changes on ISP pipeline require the use of `initPipe()` when using Halide.
    Reviewed By: fbrig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
    [Raw2Rgb.cpp]
2017-02-16 ISP path generation fix
    Summary: Made an assumption that iterating through list of cameras would be from 0 to 16, but it does 0,1,10..16,2..9. Therefore, we are safer looking at the camera number in `camX`, and mapping that to the sorted serial numbers.
    Differential Revision: D4564066
    fbshipit-source-id: 2158396953063bb401e5da5a9f428f14bdda4539
    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
2017-02-19 a fix to ignore database rows where the data column is empty. This pr…
    …events exceptions from being thrown on line 87
    Closes https://github.com/facebook/Surround360/pull/168
    Differential Revision: D4585676
    fbshipit-source-id: 5c86f2a8abfc574b8b5fc2fcae65e5bc6c365426
    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
2017-02-21 New unpacker: add frame range
    This diff adds start frame and frame count parameters to the new unpacker.
    It also adds gflags support and debugging statements for progress. Paths to .bin files are now given via comma-separated strings in `--bin_list`. For example:
    ./bin/NewUnpacker \
    --logbuflevel -1 \
    --stderrthreshold 0 \
    --isp_dir ~/Desktop/render/config/isp \
    --output_dir ~/Desktop/render/rgb \
    --bin_list ~/Desktop/binaries/0.bin,~/Desktop/binaries/1.bin \
    --start_frame 0 \
    --frame_count 10
    Differential Revision: D4585593
    fbshipit-source-id: e138a7a3adbe98d7bbbc5e24dcfdd973b8046db4
    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
2017-02-21 Geometric calibration: adapt to new file structure
    This diff slightly modifies the geometric calibration code to adapt it to the new file structure.
    It also adds code to convert input images to 8-bit, since COLMAP does not accept 16-bit images.
    Differential Revision: D4591447
    fbshipit-source-id: 3f3abf5a9d2bed2bf64d96ae3685e9d3681eccf5
    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
2017-02-26 Typo causes compilation error
    Summary: Added a period at the end of a line by mistake after testing but before committing a diff. The compiler didn't like it.
    Differential Revision: D4618272
    fbshipit-source-id: d8ca9ad38428bdb3bff8fbddc0ec7309184110bd
    [CameraIspGen.cpp]
2017-03-13 Fix unpacker compilation
    In D4657874 we deleted the new unpacker by mistake, and this was causing compilation errors.
    Putting it back.
    Reviewed By: retrotherobot
    Differential Revision: D4699014
    fbshipit-source-id: c4dc27f1d9ab55aa009d32a31f5ef00a6990e6db
    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
    [BinaryFootageFile.cpp, BinaryFootageFile.h, RawConverter.cpp, RawConverter.h, Unpacker.cpp]
2017-03-15 Remove old rig json format
    This diff removes the old rig format. No new functionality is added to the new format, so people that still want to use the old format they can use a previous commit.
    Significant changes:
    - Refactored `RigDescriptor` to be used outside `TestRenderStereoPanorama`
    - Removed no longer used: `TestIntrinsicCalibration`, `TestImageWarper`, `TestRingRectification`, `TestOpticalCenterVisualization`, `TestRenderWithoutSides`
    Differential Revision: D4601361
    fbshipit-source-id: faeee207b09b044c400988b067b1f5fad52a8eba
    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
    [Camera.cpp, Camera.h, ImageWarper.cpp, ImageWarper.h, PoleRemoval.cpp, PoleRemoval.h, RawConverter.h]
2017-03-21 New features for camera UI: gain, timelapse, fps choices, auto shutter list
    This diff adds new features to the camera capture UI, including:
    - Gain control (in dB for now)
    - Frame rate options: 24fps, 30fps, timelapse (capture a frame every X seconds)
    - Shutter ranges limits automatically update with chosen frame rates
    Differential Revision: D4733912
    fbshipit-source-id: 2377188ed535de4dcb9afded5eccdadb57a6934c
    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
2017-03-22 @allow-large-files [s360] Update manual to fix side camera ring orientation
    Summary: There was a bug on the user manual where the side camera ring was rotated 180 degrees, which was causing geometric calibration issues. The camera rig json file assumed cam1 was cam8, cam2 was cam9, etc.
    Differential Revision: D4751889
    fbshipit-source-id: ed12b9f61459e38e48c6be1c66447f4157546030
    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
2017-03-24 support old and new file structure convention
    Summary: it's a compile time switch, perhaps make runtime later
    Differential Revision: D4773512
    fbshipit-source-id: c3f0f23037bc22ca5cb61e942bc9c5e5e4998e1c
    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
2017-04-05 add windows support to Camera
    instead of building folly, provide an interposer that
    mimics folly::dynamic's sensible interface using boost
    Differential Revision: D4838007
    fbshipit-source-id: f8bcd456111de7a0d53e57f8562c128bbc01e39a
    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
2017-04-13 Unpacker: skip binary file if no cameras
    When testing with a single camera, one of the binary files does not have any data, and the function `getNumberOfFrames` in `BinaryFootageFIle.cpp` throws a floating point exception because it tries to divide by zero.
    This diff fixes this by skipping the binary if it has no cameras.
    Differential Revision: D4881566
    fbshipit-source-id: 54aec5ec1ff7fa1af5261ceef428ee628d642c6b
    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
    [BinaryFootageFile.cpp, Unpacker.cpp]
2017-04-13 Unpacker: non thread-safe serial number set
    This diff splits the set that holds serial numbers during unpacking to a separate set per binary file.
    This is done because the sync functions that populate the serial number set are not thread safe, and sometimes there can be collisions when inserting elements to the set. This causes the set to not have some serial numbers, which causes directory renaming issues after unpacking (we rename directories from serial numbers to camera numbers, 0..N).
    Minor change:
    - Added log to show what serial number we're expecting. This saves us a lot of time when debugging.
    Differential Revision: D4880895
    fbshipit-source-id: 3107c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
    [Unpacker.cpp]
2017-04-24 ISP readme: add vignetting and low/high key
    Summary: Updated README file to add explanation for some current default parameters.
    Differential Revision: D4941700
    fbshipit-source-id: 0649b2a67b1e374226b9b256ea031025c547ee6c
    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
2017-04-25 Fix spelling
    Summary: sharpenning -> sharpening, and other aberrations
    Differential Revision: D4947374
    fbshipit-source-id: dd5a8686e01fccf03808199111a179b91a92ca64
    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
    [CameraIspGen.cpp]
2017-04-25 Change button sensitivity depending on capture state
    It is confusing to have some buttons enabled when they are not supposed to. We should:
    - Enable only preview button until we are in preview mode
    - Disable preview button once we're in preview mode
    - Disable still button once we're recoding, and re-enable it when we're done recording (or cancel record request)
    Differential Revision: D4948677
    fbshipit-source-id: 26889070fc639a96db8e47ca760c639607dc20b7
    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
2017-04-25 Fix timelapse counter
    Summary: The frame counter for timelapse was not incremented properly, which was causing cameras to be out of sync.
    Differential Revision: D4948117
    fbshipit-source-id: 07dc1d8bffd9d3532528c94baa1eb046b91c3bf3
    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
    [CameraController.cpp]
2017-04-25 Unpacker: fix division by zero when printing progress
    Summary: When frame count is zero, dividing by FLAGS_frame_count when printing progress causes a floating point exception. We should pre-calculate the total frame count and use that.
    Differential Revision: D4949187
    fbshipit-source-id: 61e14d242c745a826ebf4ca796eaa4f402031444
    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
    [Unpacker.cpp]
2017-04-26 Render: frame X of Y
    Summary: This diff adds a total frame count on each new frame render log, so we know how much we have left.
    Differential Revision: D4954702
    fbshipit-source-id: 422831120ceafcfbcf945c2c36f80461533fb5f7
    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
2017-04-26 Unpacker: raw without ISP files
    With this diff, if ISP files are not provided we can still unpack RAW frames.
    This is useful when acquiring images for color calibration, for example.
    - Checking if ISP file exists, rather than just letting the json parser complain about missing attributes.
    - Checking for RGB files only if we select render.
    Differential Revision: D4952312
    fbshipit-source-id: 300eb67b14b4484d124a6c7a38d7595511842cee
    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
    [Unpacker.cpp]
2017-04-26 Camera control UI: make function a class member
    Summary: Fixed bug that prevented compilation. `startPreview` needs to be declared as member of `MainWindow`
    Differential Revision: D4956949
    fbshipit-source-id: af7d63959cfc1421cae5db48b9710f7b2e194a15
    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
    [MainWindow.cpp]
2017-04-26 Camera control UI: force param update on preview
    Summary: Shutter and bit depth were not set when clicking on Preview. With this diff we force the cameras to update parameters when starting preview mode.
    Differential Revision: D4943538
    fbshipit-source-id: 048ce721704fce20f799f2a074b70e11543f890d
    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
2017-04-29 Use min fps on timelapse to get longer possible shutter
    Summary: Instead of forcing 10fps, set the lowest possible frame rate when selecting the timelapse option. This allows us to use the longest possible shutter.
    Differential Revision: D4943400
    fbshipit-source-id: 5782df843ea485f4e03cabb8047ecb43f910f0a3
    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
2017-05-01 Calibration: use serial numbers instead of camera ordinals
    The unpacker expects ISP config files with the format `<serial_number>.json`, but color and vignetting calibration use `ispX.json`.
    This diff modifies these calibration scripts so that we can use the expected format, and not having to rename the files later on.
    Differential Revision: D4978283
    fbshipit-source-id: 90a246650782c17f080339be5e33bf64b936193c
    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
2017-05-01 Color calibration: increase dilation
    Summary: Using 1 pixel dilation for black hole detection is sometimes not large enough, specially when not all the pixels on a single channel are found (i.e. there's a larger distance between two pixels).
    Differential Revision: D4978425
    fbshipit-source-id: e9cd1f31653a6705de999169a4d910086f842622
    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
2017-05-01 Add new sample data and instructions
    Data samples on GitHub are outdated and not compatible with the way we currently render.
    We have captured, unpacked and rendered new sample data, and uploaded it to S3. Paths are specified on the top level README.
    Also added instructions on how to generate an alternating left-right GIF to check stereo on a single frame.
    Differential Revision: D4979763
    fbshipit-source-id: 21cceea80a9fa31b49745baba59f4ef395f82c45
    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
2017-05-25 written error in TestVignettingCalibration.cpp
    in TestVignettingCalibration.cpp , line 385:
    cameraIsp.getImage(rawTestIspOut)
    should be cameraIspTest.getImage(rawTestIspOut)?
    Closes https://github.com/facebook/Surround360/pull/220
    Differential Revision: D5133104
    fbshipit-source-id: 397317347cccd7f74d5d0433986e74cfca8c75eb
    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
2018-03-30 Change errorFunction
    At surround360_render/source/optical_flow/PixFlow.h line 520, when calculating horizontal RegularizationCoef related error, denominator I0.cols is change to I1.rows.
    `horizontalRegularizationCoef * fabsf(flowDir.x) / float(I0.rows);`
    instead of
    `horizontalRegularizationCoef * fabsf(flowDir.x) / float(I0.cols);`
    Closes https://github.com/facebook/Surround360/pull/256
    Differential Revision: D7455669
    fbshipit-source-id: 84e2aa90a6fd9737911c0f295aa7365689ebbf51
    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
    [PixFlow.h]
2018-11-05 Add copyright messages to open source files
    Summary: Some files were missing copyright notices.
    Differential Revision: D12874880
    fbshipit-source-id: d2d30385e2f5e791d7e3881c107dde2589d64268
    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
    [BinaryFootageFile.cpp, BinaryFootageFile.h, DngTags.h]
